MridulNegi2005/Capstone/Braillix_Hardware_Report.docx

BRAILLIX

Hardware Architecture Report

Internal Technical Reference for Software Team

Version 1.0 | 2026-05-08

Mechanical Design Team

# Table of Contents

# 1. Executive Summary

Braillix is a modular, mechanically-actuated refreshable Braille display. Each cell is a self-contained unit housing a stepper motor, a custom 6-track cam disc, 6 linkages, and 6 Braille dot pins. An external ESP32 Brain Pod provides computation, power, and user input via 3 navigation buttons. Multiple cells chain together over I2C via magnetic-snap pogo connectors.

Core innovation: The cam disc encodes all 64 Braille characters (6-bit binary) as physical track heights. Rotating the disc to the correct angular position mechanically raises or lowers the appropriate dots — no solenoids, no per-dot actuators. One motor per cell drives the entire 6-dot character.

# 2. System Architecture

## 2.1 Top-Level Components

- 1× ESP32 Brain Pod — master controller, power input, user interface
- N× Braille Cells — slaves, chained left-to-right via pogo connectors
- Each cell contains: 28BYJ-48 stepper + ULN2003 driver + cam disc + 6 linkages + Hall sensor + top plate + 6 dot caps

## 2.2 Communication

- Protocol: I2C (SDA + SCL)
- Power rail: 5 V distributed through pogo pin chain
- Pogo signals: 5V, GND, SDA, SCL (4 pins per face)
- Bus topology: Daisy-chain — pod right-face → cell 1 left-face → cell 1 right-face → cell 2 left-face → …
- Addressing: Each cell has a unique 7-bit I2C address assigned at boot or via hardware jumpers

# 3. Braille Cell — Mechanical Overview

## 3.1 Outer Box (Cell Enclosure)

- External dimensions: 68 × 68 × 57 mm (L × W × H), material: PETG
- Pogo interfaces: Both ±X faces have pogo slots (10 mm wide × 8 mm tall) at z = 30.5 mm
- Magnet pockets: 3× Ø3.2 mm × 2.1 mm deep on both ±X faces at y = [−12, 0, +12] mm — NeFeB snap alignment
- Braille 'F' emboss: Front wall (−Y) has Braille dots 1, 2, 4 embossed — tactile orientation marker for blind user

Internal Z-stack (bottom → top):

Z Range (mm) | Layer | Contents
0 – 4 | Floor | PETG shell floor
4 – 20 | Electronics pocket | ULN2003 driver board + wiring (16 mm tall)
20 – 22 | Mid-plate | 2 mm solid PETG — seals electronics from motor cavity
22 – 41 | Motor cavity | 28BYJ-48 body in motor collar on mid-plate
41 – 46 | Base plate | 5 mm PETG — motor ears mount here; cam pocket on top face
43 – 46 | Cam disc | 3 mm deep pocket; disc sits here, hub hangs below
46 – 54 | Linkage zone | 8 mm standoffs; 6 linkages travel here (12 mm total height)
54 – 57 | Top plate | 4 mm resin plate; braille holes + spring pockets

## 3.2 Motor — 28BYJ-48 Stepper

- Type: Unipolar 5-wire stepper with built-in planetary gearbox
- Step angle: 5.625° per electrical step
- Gear ratio: ~1:64 → effective 4096 full steps per revolution
- Voltage: 5 V DC, current ~150–250 mA per phase
- Driver: ULN2003A Darlington array (on breakout board in electronics pocket)
- Shaft: D-profile, 5 mm diameter, flat cut to 3 mm across flats
- Body offset: Motor body centre is −8 mm in X from shaft centre — shaft stays at x = 0 for cam alignment
- Mounting ears: at x = [−25.5, +9.5] mm on base plate

## 3.3 Cam Disc — Character Encoding

This is the mechanical core of Braillix. A single 3D-printed disc encodes all 64 Braille characters as concentric annular track heights.

Geometry:

Parameter | Value | Notes
Tracks | 6 | One per Braille dot
Inner radius | 8.0 mm | Track 0 inner edge
Track width | 1.6 mm | Per track
Track gap | 0.1 mm | Between adjacent tracks
Outer radius | 18.2 mm | = 8.0 + 6×1.7 mm
Base thickness | 2.0 mm | Dot DOWN height
Bump height | 0.8 mm | Additional height when dot UP
Ramp fraction | 30 % | Smooth rise/fall per slice (avoids shock)
Angular slices | 64 | One per Braille character (5.625° each)
Hub depth | 4 mm below | Inverted hub — top face completely clear for linkage feet
Hub diameter | 9 mm OD | D-shaft socket: 5.2 mm dia, flat to 3.2 mm

Encoding scheme: State index N is at angle N × 5.625°. For each track T, bit T of N determines whether track T at that angle is high (+0.8 mm bump) or low (base only). All 6 tracks are read simultaneously by 6 linkage feet sitting at Y = 0.

Homing magnet: 1× Ø3 mm NeFeB disc press-fit on disc underside at radius = 17.35 mm, angle = 90° (+Y axis). Triggers Hall sensor on base plate when disc is at character-0 home position.

## 3.4 Linkages (Laser-cut Metal Cranks)

6 laser-cut cranks in 1 mm stainless steel or aluminium sheet. These transfer vertical cam surface height into vertical dot-pin motion.

Dot | Track r (mm) | Dot position (x, y) mm | Arm span (mm) | Assembly angle
0 | 8.85 | (−2.4, +2.6) | 11.55 | −13.0°
1 | 10.55 | (−2.4, 0.0) | 12.95 | 180.0°
2 | 12.25 | (−2.4, −2.6) | 14.88 | +10.1°
3 | 13.95 | (+2.4, +2.6) | 11.84 | −12.7°
4 | 15.65 | (+2.4, 0.0) | 13.25 | 0.0°
5 | 17.35 | (+2.4, −2.6) | 15.18 | +9.9°

Key features:

- Foot: 2.0 mm wide × 2.5 mm long, rounded tip — rides on cam track
- Arm: horizontal bar, staggered heights prevent inter-linkage collision
- Nub: 1.2 mm wide × 1.5 mm tall rectangular tab — protrudes up through top plate hole into braille cap socket
- Total height: 12.0 mm (foot bottom → nub top)
- Arm heights: dots 0,3 = 2.0 mm; dots 1,4 = 5.5 mm; dots 2,5 = 9.0 mm (staggered to prevent collision)
- Critical: All 6 feet read the cam at the same angular position (Y=0 axis) simultaneously — one motor move = one complete character change

## 3.5 Top Plate

- Material: RESIN / SLA/MSLA — FDM cannot hold Ø2.0 mm tolerance (pins jam)
- Dimensions: 60 × 60 × 4 mm
- Braille holes: 6× Ø2.0 mm through-holes — 0.1 mm clearance over 1.9 mm cap pin
- Spring pockets: 6× Ø3.5 mm × 3.0 mm deep on underside — retains return springs
- Springs: OD 3–3.5 mm, free length 6–8 mm, k ≤ 0.1 N/mm — returns dots to DOWN state
- Dot layout: Left col dots 0,1,2 at x = −2.4 mm; Right col dots 3,4,5 at x = +2.4 mm; Row pitch = 2.6 mm
- Mounting: 4× M2.5 button-head screws at ±15 mm from centre, counterbored on top
- Thumb ridge: 8 mm wide bump on bottom edge — tactile orientation aid for blind user

## 3.6 Braille Dot Caps

- Material: PETG (FDM) or resin
- Pin: Ø1.9 mm × 5.5 mm — slides freely through Ø2.0 mm top plate hole
- Flange: Ø3.0 mm × 1.0 mm below plate — prevents cap falling through hole
- Body: Ø3.5 mm × 1.5 mm above plate surface
- Bearing ball cup: Ø2.2 mm hemispherical recess on top — 2 mm stainless steel ball CA-glued in
- Linkage socket: 1.3 × 1.1 mm rectangular blind socket in pin bottom — receives 1.2 × 1.0 mm metal nub from linkage
- Touch surface: Grade-100 stainless steel bearing ball — cold, smooth, long-lasting

Dot states:

- DOWN (rest): Cam base = 2.0 mm → foot low → nub flush with plate top → ball ~0 mm proud
- UP (active): Cam bump = 2.8 mm → foot raised 0.8 mm → nub 0.8 mm above plate → ball 0.8 mm proud — felt by fingertip

# 4. ESP32 Brain Pod

## 4.1 Enclosure

- External dimensions: 74 × 38 × 58 mm (L × W × H)
- Material: PETG, split into Shell + Lid for assembly access
- Lid: 4 mm thick, barrel jack on top face, locating lip for shell alignment
- Internal space: 66 × 30 mm footprint, 54 mm internal height

## 4.2 Microcontroller — ESP32 NodeMCU 30-pin

- PCB size: 51 × 29 mm
- Mounting: 4× M2 self-tap boss posts at ±23 mm (X) × ±11 mm (Y), 4 mm above pod floor
- Programming: Micro-USB port on left face (−X wall), always externally accessible
- Wireless: 2.4 GHz WiFi + BLE — antenna faces +X through 1.5 mm thinned wall + 3 grille slots
- Logic: 3.3 V (check pin tolerance before connecting 5 V peripherals directly)
- Flash: 4 MB

## 4.3 Power Supply

- Input connector: 5.5/2.1 mm barrel jack, centre-positive, on pod lid
- Rail: 5 V distributed from pod → pogo chain → all cells
- Per-cell budget: 28BYJ-48 draws 150–250 mA; size PSU at 300 mA × cell count + 200 mA for ESP32

## 4.4 Navigation Buttons

Button | Symbol | X position | Function
Previous | ◁ raised triangle | −20 mm | Scroll / page backward
Select | ○ raised ring | 0 mm | Confirm / activate
Next | ▷ raised triangle | +20 mm | Scroll / page forward

- Switch: 6×6×5 mm DIP tactile switch — mounted on ESP32 PCB at matching positions
- Cap shaft: Ø4.0 mm × 4.5 mm — passes through Ø4.2 mm wall hole, 0.5 mm protrudes inside to press switch
- Height: z = 24.4 mm from pod bottom (42% of pod height — comfortable thumb reach)
- Symbols RAISED 0.8 mm — tactile identification for blind user without vision
- GPIO: Active LOW (switch pulls GPIO to GND); enable internal pull-up in firmware
- Debounce: 20–50 ms in firmware

## 4.5 Pogo Pin Interface (Pod → Cell 1)

- Location: Right face (+X) of pod
- Signals: 5V, GND, SDA, SCL
- Recess: 10 mm wide × 8 mm tall, 1 mm deep — prevents spring pins shorting if misaligned
- Centroid height: z = 30.5 mm from pod bottom — must match cell pogo_z exactly
- Alignment: 3× Ø3 mm NeFeB disc magnets at y = [−12, 0, +12] mm, alternating N/S — single correct orientation

# 5. Cell-to-Cell Chaining

## 5.1 Mechanical Connection

- Cells connect right-face (+X) of one cell to left-face (−X) of next
- Magnetic snap: 3× Ø3 mm NeFeB per face, alternating polarity — ~2 N hold force, fool-proof orientation
- No screws, no tongue-and-slot — magnets only (removes over-constraint)

## 5.2 Electrical Connection (Pogo Pins)

- Spring pins on +X face press against pad targets on −X face of next cell
- 4 signals passed: 5V, GND, SDA, SCL
- 1 mm recess on pad side prevents shorts during docking
- Last cell: TPU snap-fit end cap covers exposed right-face spring pins

## 5.3 I2C Bus Topology

- SDA + SCL shared across all cells on one continuous bus
- Pull-up resistors: 4.7 kΩ — place on ESP32 pod PCB
- Each cell needs a unique 7-bit address
- Suggested: Address jumper pads (J0, J1, J2) on cell PCB give 8 combinations (addresses 0x20–0x27)

# 6. Electronics Stack (Per Cell)

## 6.1 ULN2003 Driver Board

- Located in electronics pocket (z = 4–20 mm inside outer box)
- Drives 28BYJ-48 in half-step mode (8-step sequence) or full-step (4-step)
- 4 control lines from MCU: IN1, IN2, IN3, IN4
- Consider ATtiny85/ATmega328 as per-cell I2C slave: handles motor stepping + Hall sensor, reports to ESP32 master

## 6.2 Hall Effect Sensor (Homing)

- Mounted on base plate at y = +20 mm (+Y axis)
- Detects homing magnet on cam disc underside at radius = 17.35 mm, θ = 90°
- Type: Digital Hall switch — e.g. AH3144, SS49E — output active LOW when magnet present
- GPIO: 1 digital input per cell with internal pull-up
- Use: Rotate until LOW → that is character 0 / home

## 6.3 Wiring Summary

- ULN2003 ↔ Motor: 5-wire JST connector
- MCU → ULN2003: 4× GPIO (IN1–IN4)
- MCU → Hall sensor: 1× GPIO + VCC + GND
- Pogo wire bundle: 4 wires (5V, GND, SDA, SCL), cable-tied to post inside cell near +X wall

# 7. Software Interface Requirements

## 7.1 Motor Control

- Steps per revolution: 4096 full steps (64 electrical steps × 64:1 gear ratio)
- Steps per character: 4096 ÷ 64 characters = 64 full steps (or 128 half-steps)
- Max step rate: ~500 Hz before stall — use slow ramp-up; start at ~200 Hz
- Direction: Define CW / CCW in firmware based on physical motor orientation

## 7.2 Homing Sequence (run on power-up per cell)

1. Rotate motor CW until Hall sensor output goes LOW (character 0 position)
2. Record current step count as zero reference
3. All subsequent positions: target_steps = target_char × 64 from home

## 7.3 Character Display

1. Receive character code (0–63) over I2C from ESP32 master
2. Calculate delta = (target − current) × 64; choose shortest direction (CW or CCW)
3. Step motor to target position
4. Optionally verify with Hall sensor at character 0 periodically

## 7.4 Suggested I2C Protocol

- Write (display character): Master → [addr][char_code] → cell drives motor
- Read (status): Master reads [addr] → cell returns [current_char][status_byte]
- Broadcast: Address 0x00 → all cells update simultaneously (useful for page turns)

# 8. Braille Character Mapping

The cam disc uses standard 6-bit binary encoding, compatible with Grade 1 Braille (ISO 17049):

Bit | Dot number | Position | Cam track
Bit 0 (LSB) | Dot 1 | Top-left | Track 0 (innermost, r = 8.85 mm)
Bit 1 | Dot 2 | Middle-left | Track 1 (r = 10.55 mm)
Bit 2 | Dot 3 | Bottom-left | Track 2 (r = 12.25 mm)
Bit 3 | Dot 4 | Top-right | Track 3 (r = 13.95 mm)
Bit 4 | Dot 5 | Middle-right | Track 4 (r = 15.65 mm)
Bit 5 (MSB) | Dot 6 | Bottom-right | Track 5 (outermost, r = 17.35 mm)

- State 0 (0b000000) = all dots down = blank / space
- State 1 (0b000001) = dot 1 only = Braille letter A
- State 3 (0b000011) = dots 1+2 = Braille letter B
- Full mapping: ISO/ANSI Braille standard tables (provide to firmware team)

# 9. Key Dimensions — Quick Reference

Parameter | Value | Notes
Cell external | 68 × 68 × 57 mm | L × W × H
Pod external | 74 × 38 × 58 mm | L × W × H
Braille col spacing | 4.8 mm | Left col at x = −2.4, right at x = +2.4
Braille row spacing | 2.6 mm | Rows at y = +2.6, 0, −2.6 mm
Dot travel (UP) | 0.8 mm | Cam bump height — fingertip detectable
Cam outer radius | 18.2 mm | 6 tracks at 1.7 mm pitch each
Steps / character | 64 full steps | 4096 steps/rev ÷ 64 characters
Pogo centroid height | 30.5 mm | From bottom of cell or pod — must match
Nav button height | 24.4 mm | From pod bottom (42% of 58 mm)
Motor supply | 5 V, ~200 mA avg | Peak 250 mA per phase; budget 300 mA/cell
I2C pull-up | 4.7 kΩ | On pod PCB; do not duplicate on each cell
Hall sensor | r = 17.35 mm, θ = 90° | On base plate at y = +20 mm
Cam slice angle | 5.625° | 360° ÷ 64 characters

# 10. Bill of Materials (Hardware)

## 10.1 Per Braille Cell

Item | Specification | Qty | Notes
Stepper motor | 28BYJ-48, 5 V | 1 | Usually sold with ULN2003 board
ULN2003 driver | Darlington array breakout | 1 | Included with motor kit
NeFeB disc magnet | Ø3 mm × 2 mm | 6 | 3 per ±X face, alternating N/S
Bearing ball | 2 mm grade-100 stainless steel | 6 | CA-glued into dot cap cup
Compression spring | OD 3–3.5 mm, L 6–8 mm, k ≤ 0.1 N/mm | 6 | Dot return springs
Hall effect sensor | Digital switch (AH3144 or SS49E) | 1 | Homing detection, active LOW
Pogo pin | Spring contact, 5 V rated | 8 | 4 per ±X face
M2.5 screw | Button-head, 6 mm | 4 | Top plate mounting (counterbored)
M2 screw | Self-tapping, 6 mm | 4 | Cell PCB boss mounting
CA glue | Cyanoacrylate (super glue) | — | Bearing balls into cups

## 10.2 ESP32 Brain Pod

Item | Specification | Qty | Notes
ESP32 NodeMCU | 30-pin, 51×29 mm PCB | 1 | Main controller
Barrel jack | 5.5/2.1 mm panel-mount | 1 | 5 V power input on pod lid
Tactile switch | 6×6×5 mm DIP | 3 | Navigation buttons (Prev / Select / Next)
NeFeB disc magnet | Ø3 mm × 2 mm | 3 | Pod-to-cell snap alignment
M2 screw | Self-tapping, 6 mm | 4 | PCB boss mounting inside pod

Page | Braillix Hardware Report v1.0 | CONFIDENTIAL

Braillix — Hardware Architecture Report
