MridulNegi2005/Capstone/renders/braillix_assembly.stl

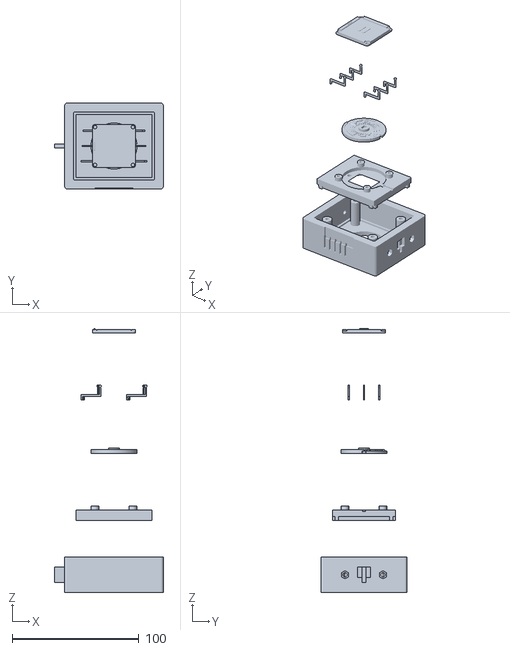
[picture p8: CAD file, 2026-05-02]
renders/braillix_assembly.stl
85.9 x 68.0 x 208.6
