MridulNegi2005/Capstone/cad/stl/linkage_asm_2.stl

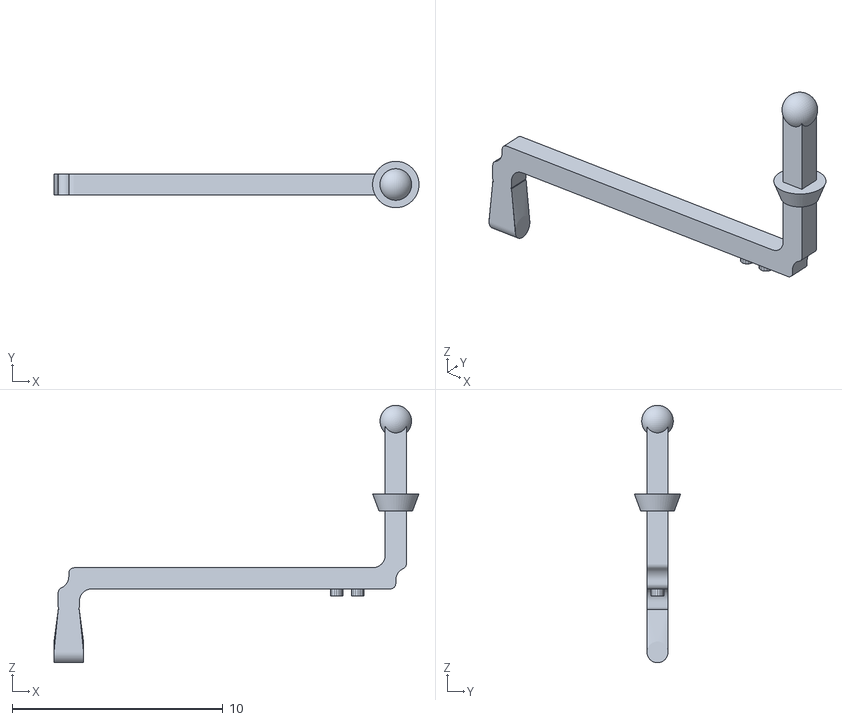
[picture p9: CAD file, 2026-07-31]
cad/stl/linkage_asm_2.stl
17.3 x 2.20 x 12.2
