MridulNegi2005/Capstone/cad/stl/linkage_asm_3.stl

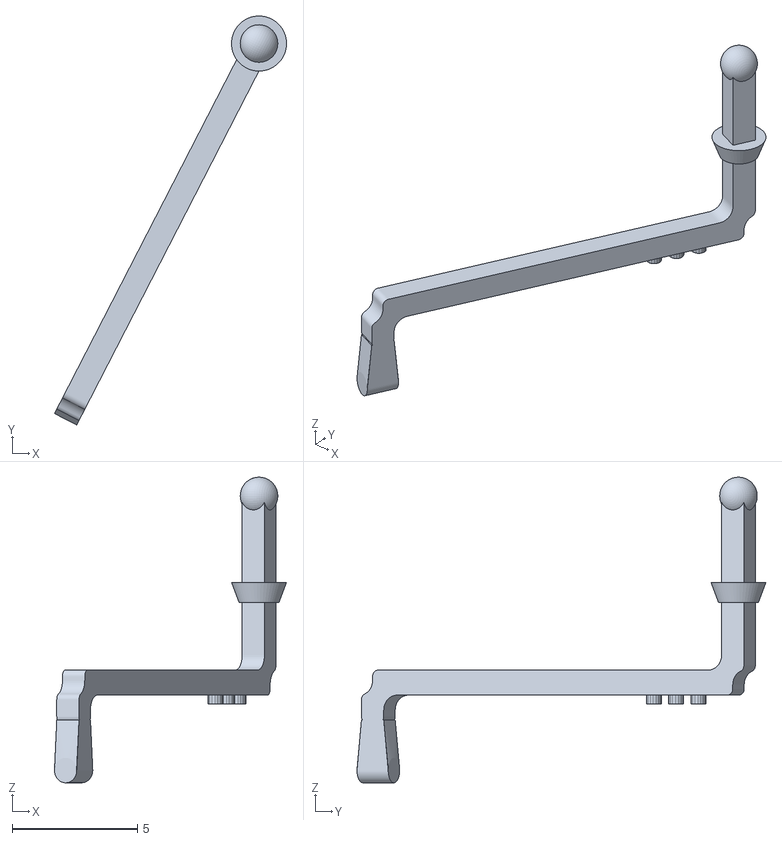
[picture p10: CAD file, 2026-07-31]
cad/stl/linkage_asm_3.stl
9.26 x 16.3 x 12.2
