MridulNegi2005/Capstone/cad/stl/linkage_asm_1.stl

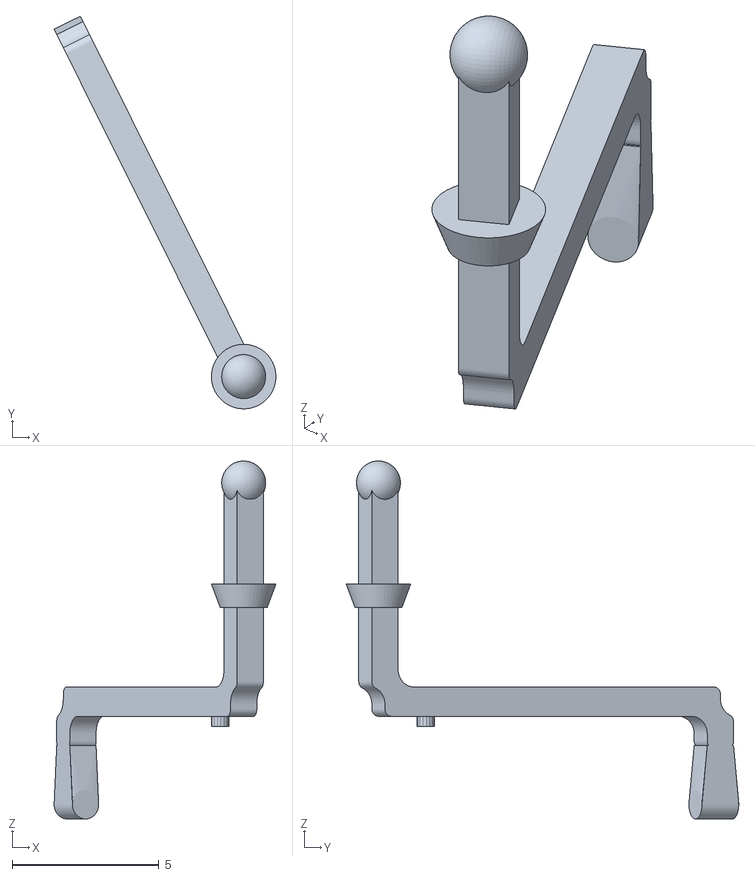
[picture p11: CAD file, 2026-07-31]
cad/stl/linkage_asm_1.stl
7.56 x 13.4 x 12.2
