MridulNegi2005/Capstone/cad/stl/linkage_asm_4.stl

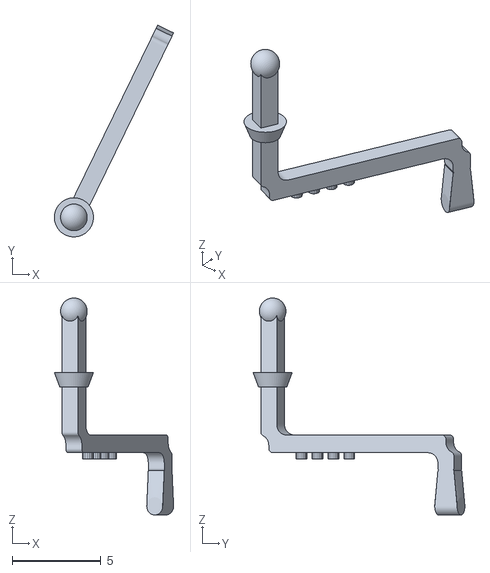
[picture p12: CAD file, 2026-07-31]
cad/stl/linkage_asm_4.stl
6.70 x 11.9 x 12.2
