MridulNegi2005/Capstone/cad/stl/linkage_asm_5.stl

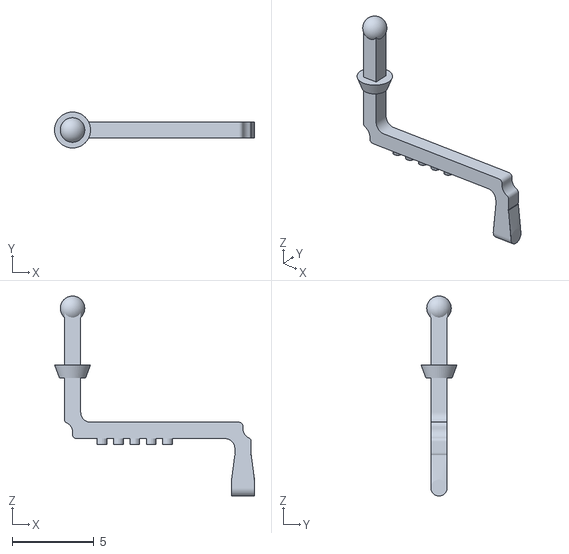
[picture p13: CAD file, 2026-07-31]
cad/stl/linkage_asm_5.stl
12.2 x 2.20 x 12.2
