MridulNegi2005/Capstone/cad/stl/linkage_asm_6.stl

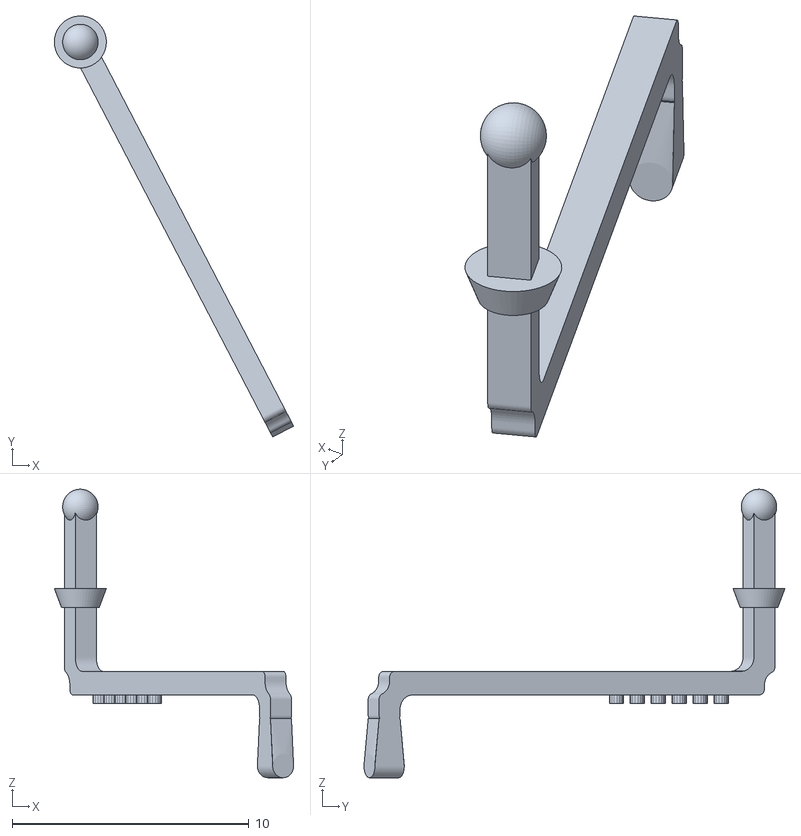
[picture p14: CAD file, 2026-07-31]
cad/stl/linkage_asm_6.stl
10.1 x 17.8 x 12.2
