MridulNegi2005/Capstone/cad/dxf/linkage_UNNAMED.dxf

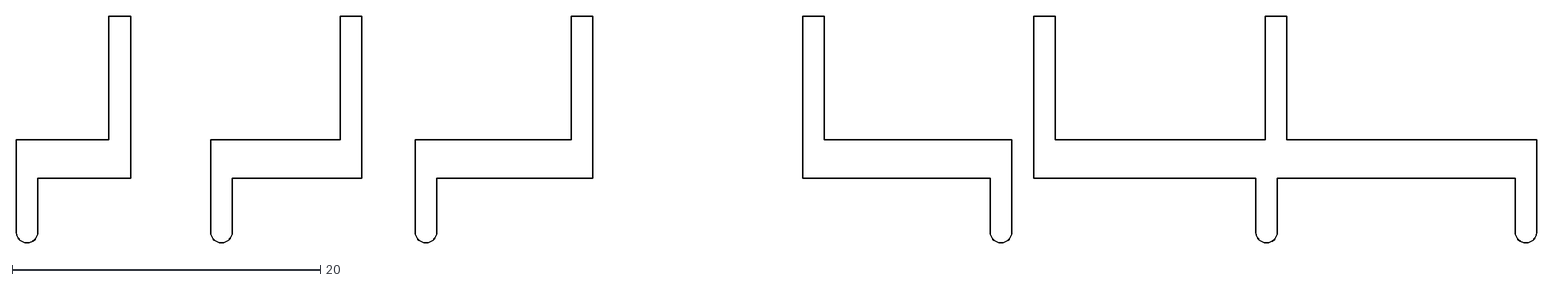
[picture p15: CAD file, 2026-05-02]
cad/dxf/linkage_UNNAMED.dxf
98.6 x 14.7
