MridulNegi2005/Capstone/cad/stl/esp32_pod_lid.stl

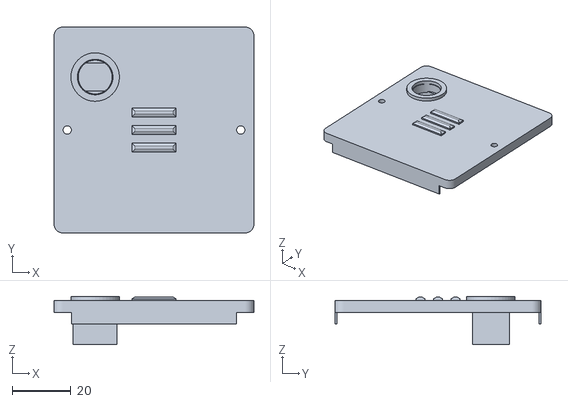
[picture p16: CAD file, 2026-08-01]
cad/stl/esp32_pod_lid.stl
68.0 x 70.0 x 16.4
