MridulNegi2005/Capstone/print_batch/Batch1_Shells/outer_box.stl

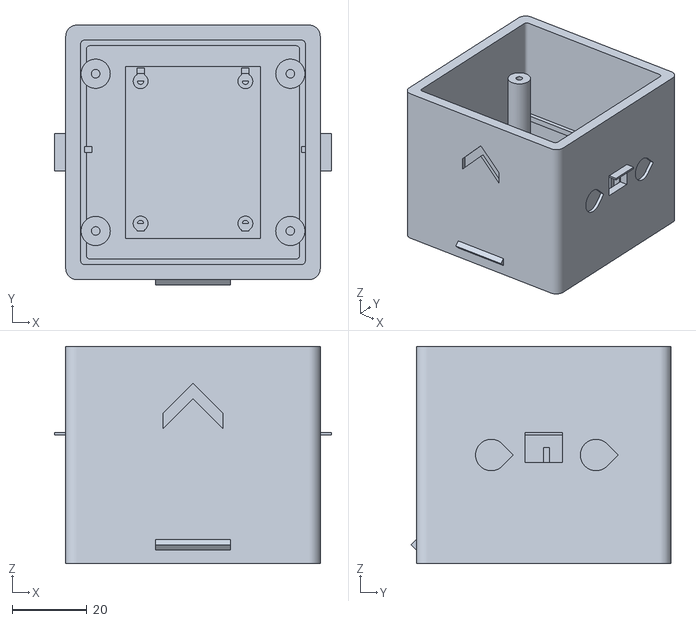
[picture p17: CAD file, 2026-07-21]
print_batch/Batch1_Shells/outer_box.stl
74.0 x 69.4 x 58.0
