MridulNegi2005/Capstone/print_batch/Batch2_Plates/esp32_pod_lid.stl

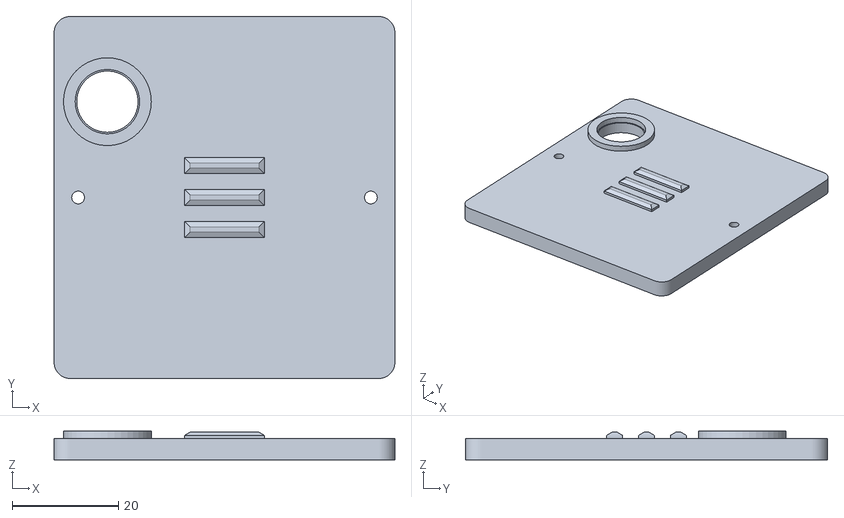
[picture p18: CAD file, 2026-07-21]
print_batch/Batch2_Plates/esp32_pod_lid.stl
64.0 x 68.0 x 5.39
