MridulNegi2005/Capstone/print_batch/Batch3_Small_Parts/pogo_end_cap.stl

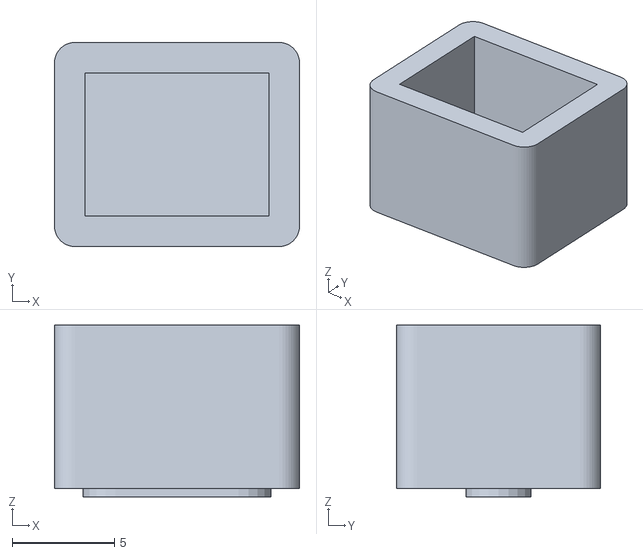
[picture p19: CAD file, 2026-07-21]
print_batch/Batch3_Small_Parts/pogo_end_cap.stl
12.0 x 10.0 x 8.40
