MridulNegi2005/Capstone/print_batch/Batch4_Resin/linkage.stl

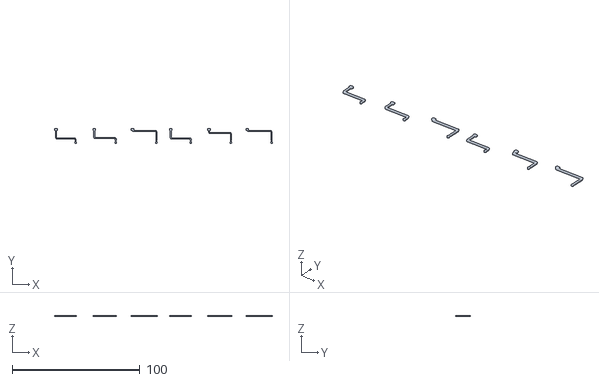
[picture p20: CAD file, 2026-07-25]
print_batch/Batch4_Resin/linkage.stl
170.9 x 12.0 x 1.00
