MridulNegi2005/Capstone/renders/Untitled.stl

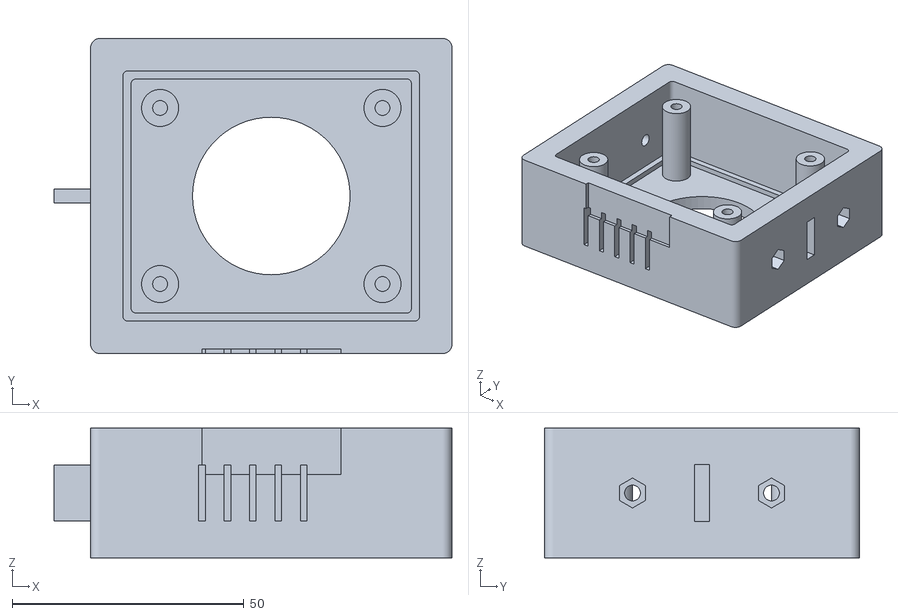
[picture p21: CAD file, 2026-05-02]
renders/Untitled.stl
85.9 x 68.0 x 28.0
