MridulNegi2005/Capstone/cad/stl/outer_box.stl

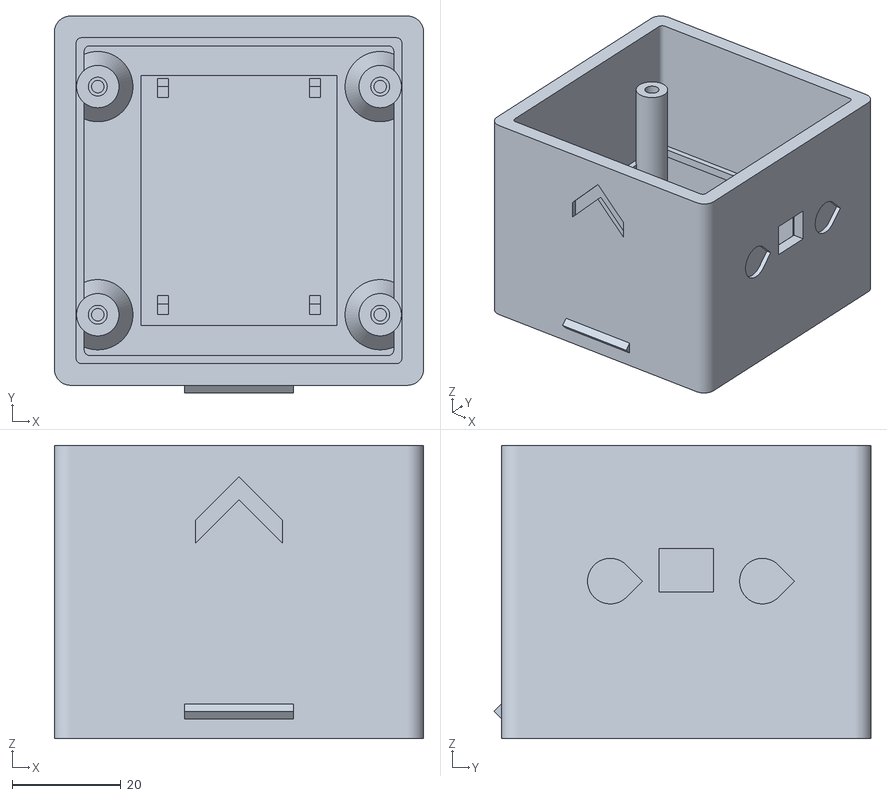
[picture p22: CAD file, 2026-08-01]
cad/stl/outer_box.stl
68.0 x 69.4 x 54.0
