MridulNegi2005/Capstone/print_batch/Batch1_Shells/esp32_pod_shell.stl

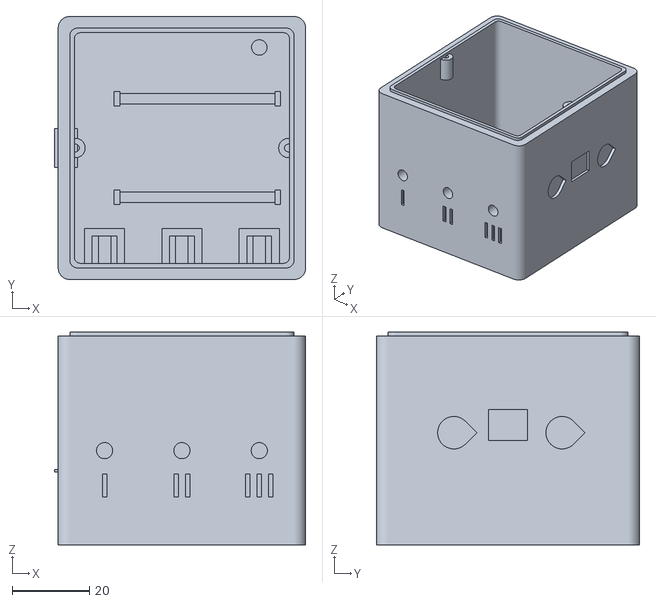
[picture p23: CAD file, 2026-07-21]
print_batch/Batch1_Shells/esp32_pod_shell.stl
65.0 x 68.0 x 55.0
