MridulNegi2005/Capstone/print_batch/Batch2_Plates/base_plate.stl

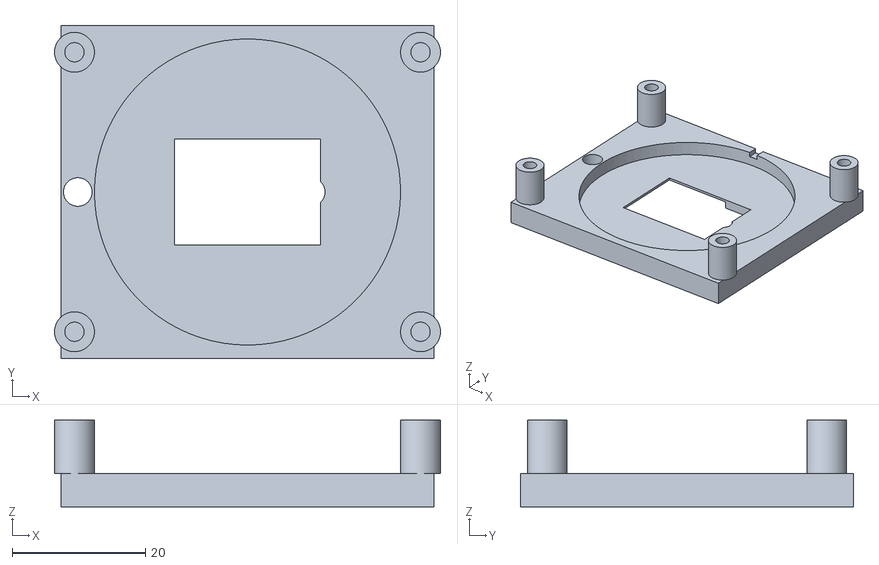
[picture p24: CAD file, 2026-07-21]
print_batch/Batch2_Plates/base_plate.stl
58.0 x 50.0 x 13.0
