MridulNegi2005/Capstone/print_batch/Batch4_Resin/braille_cam.stl

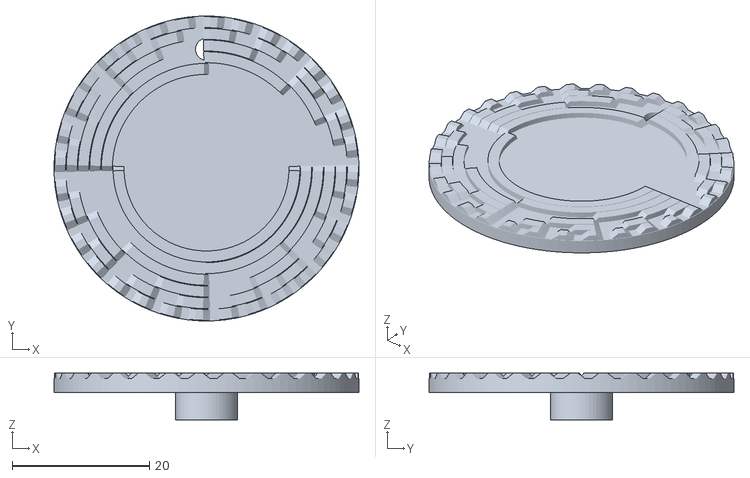
[picture p25: CAD file, 2026-07-25]
print_batch/Batch4_Resin/braille_cam.stl
44.4 x 44.4 x 6.80
