MridulNegi2005/Capstone/cad/stl/esp32_pod_shell.stl

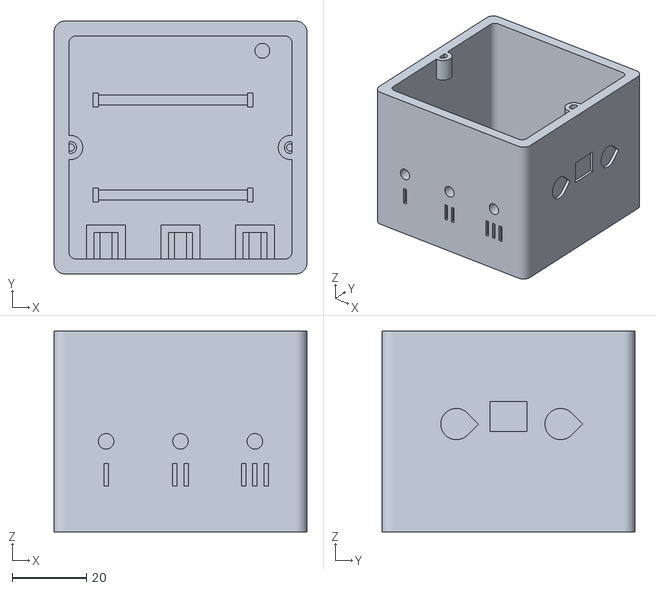
[picture p26: CAD file, 2026-08-01]
cad/stl/esp32_pod_shell.stl
68.0 x 68.0 x 54.0
