MridulNegi2005/Capstone/print_batch/Batch2_Plates/mid_plate.stl

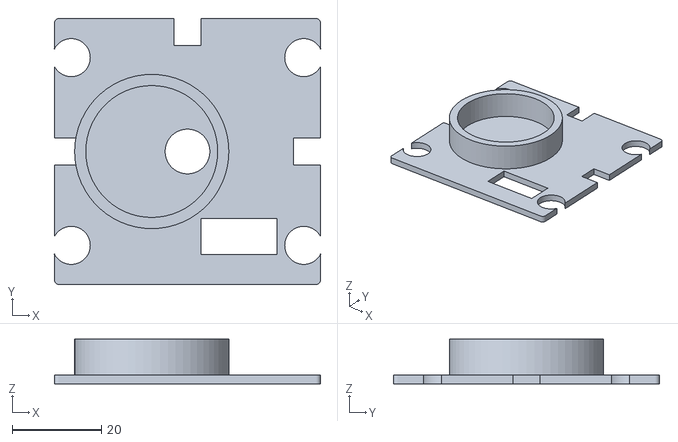
[picture p27: CAD file, 2026-07-21]
print_batch/Batch2_Plates/mid_plate.stl
59.5 x 59.5 x 10.0
