MridulNegi2005/Capstone/print_batch/Batch4_Resin/nav_cap.stl

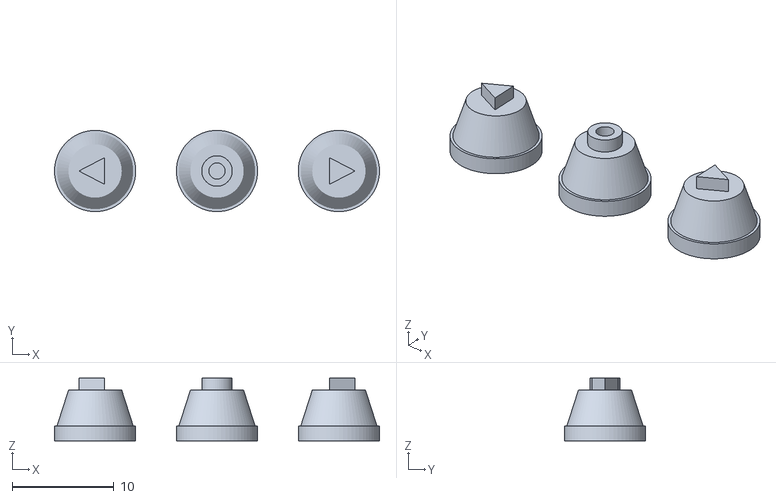
[picture p28: CAD file, 2026-06-03]
print_batch/Batch4_Resin/nav_cap.stl
32.0 x 8.00 x 6.20
