MridulNegi2005/Capstone/renders/top_plat.stl

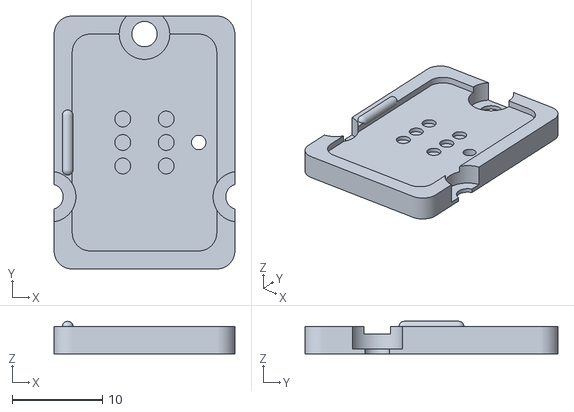
[picture p29: CAD file, 2026-02-17]
renders/top_plat.stl
20.0 x 28.0 x 3.60
