MridulNegi2005/Capstone/cad/stl/top_plate.stl

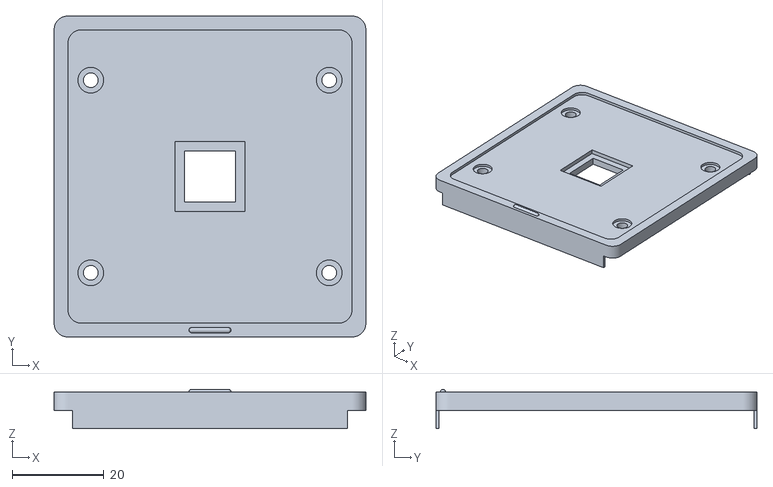
[picture p30: CAD file, 2026-08-01]
cad/stl/top_plate.stl
68.0 x 70.0 x 8.59
