MridulNegi2005/Capstone/print_batch/Batch4_Resin/top_plate.stl

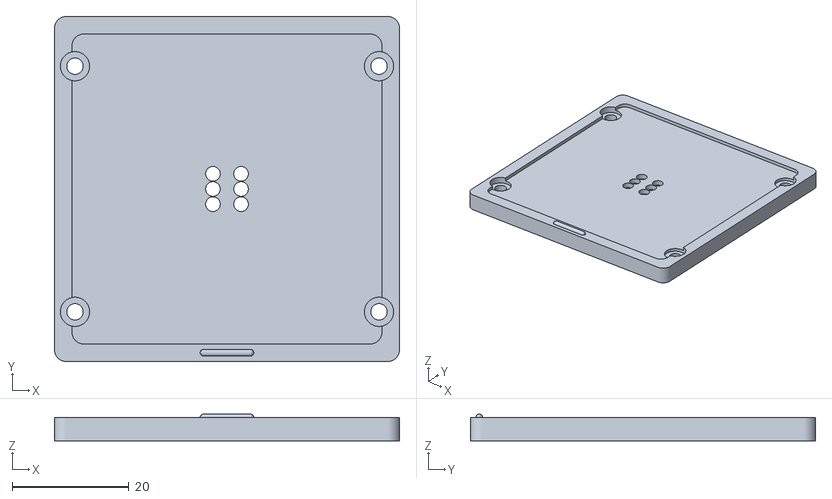
[picture p31: CAD file, 2026-06-03]
print_batch/Batch4_Resin/top_plate.stl
59.0 x 59.0 x 4.59
