MridulNegi2005/Capstone/cad/stl/print_small_parts.stl

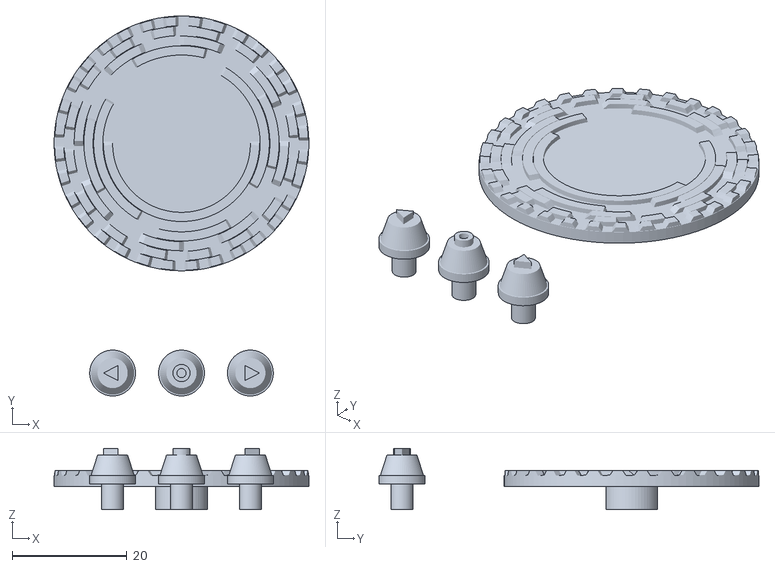
[picture p32: CAD file, 2026-07-30]
cad/stl/print_small_parts.stl
44.4 x 66.2 x 10.7
