MridulNegi2005/Capstone/cad/stl/base_plate.stl

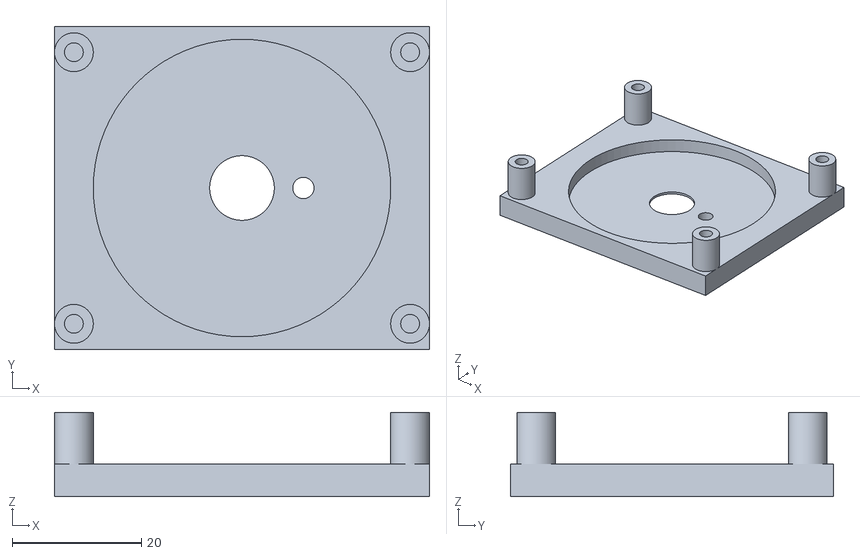
[picture p33: CAD file, 2026-07-30]
cad/stl/base_plate.stl
58.0 x 50.0 x 13.0
