MridulNegi2005/Capstone/cad/stl/nav_cap.stl

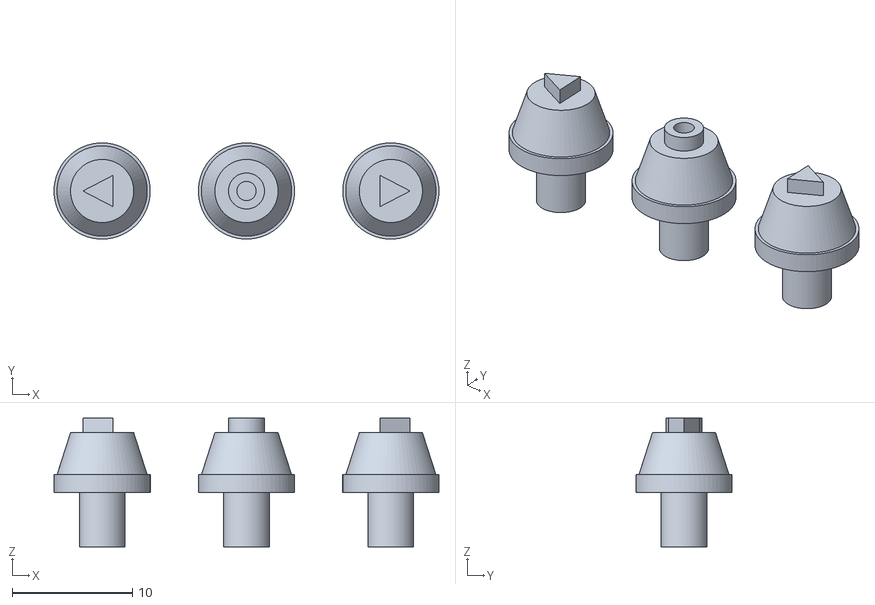
[picture p34: CAD file, 2026-07-30]
cad/stl/nav_cap.stl
32.0 x 8.00 x 10.7
