MridulNegi2005/Capstone/cad/stl/dot_insert.stl

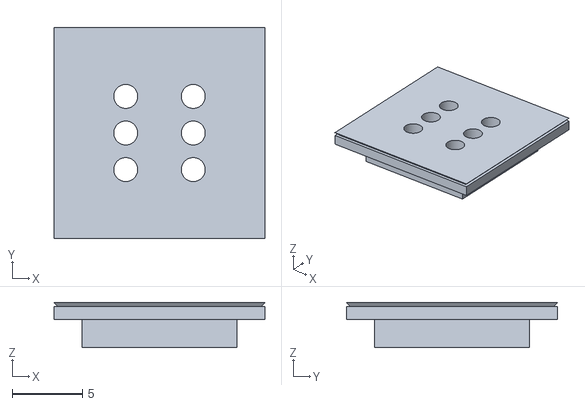
[picture p35: CAD file, 2026-07-30]
cad/stl/dot_insert.stl
15.0 x 15.0 x 3.20
