MridulNegi2005/Capstone/cad/stl/linkage.stl

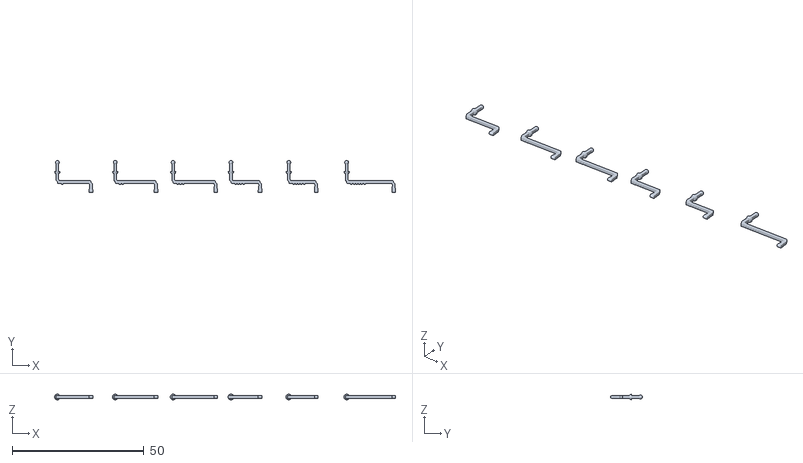
[picture p36: CAD file, 2026-07-30]
cad/stl/linkage.stl
129.7 x 12.2 x 2.20
