MridulNegi2005/Capstone/cad/stl/print_resin_cam_linkage.stl

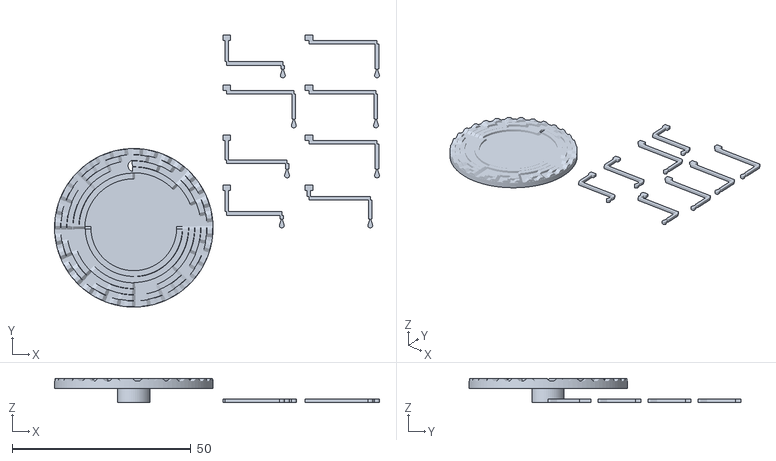
[picture p37: CAD file, 2026-07-25]
cad/stl/print_resin_cam_linkage.stl
91.0 x 76.2 x 6.80
