MridulNegi2005/Capstone/cad/stl/braille_cap.stl

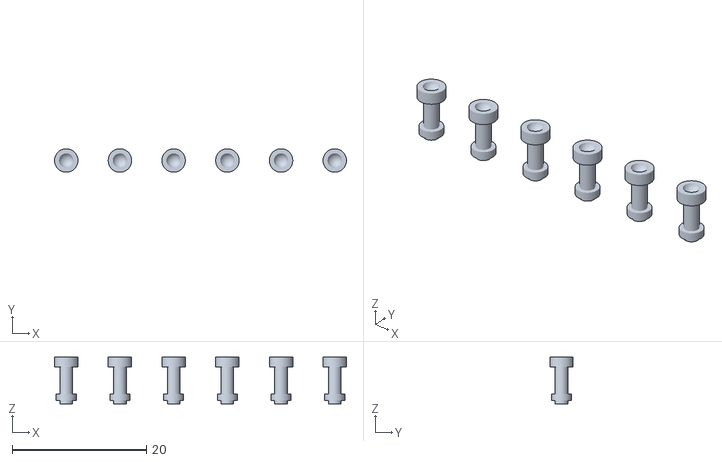
[picture p38: CAD file, 2026-05-10]
cad/stl/braille_cap.stl
43.5 x 3.50 x 7.00
