MridulNegi2005/Capstone/(list of files, cad)

Other CAD files:
cad/stl/mid_plate.stl
cad/stl/braille_cam.stl
cad/stl/pogo_end_cap.stl
_archive/test_box.scad
_archive/test_buttons_only.scad
_archive/test_buttons_only.stl
_archive/test_full_no_guards.scad
_archive/test_full_no_guards.stl
_archive/test_original.scad
_archive/test_original.stl
cad/scad/braille_cap.scad
cad/scad/dot_insert.scad
cad/scad/nav_cap.scad
cad/scad/print_resin_1_all.scad
cad/scad/print_resin_2_no_buttons.scad
cad/scad/print_resin_3_cam_linkages.scad
cad/scad/print_small_parts.scad
cad/stl/masterplan.scad
renders/braillix_assembly.blend
renders/braillix_assembly_v5.blend
