MridulNegi2005/Capstone/(commit log)

2026-05-02 refreshed designs
    [Untitled.dxf, Untitled.stl, base_plate.scad, base_plate.stl, braille_cam.scad, braille_cam2.scad, braille_cam2.stl, braillix_assembly.blend]
2026-05-02 fixed file structures
    [Untitled.stl, base_plate.scad, base_plate.stl, braille_cam.scad, braille_cam2.scad, braille_cam2.stl, braillix_assembly.stl, linkage.scad]
2026-05-02 added hardware renders
    [braillix_assembly.blend]
2026-05-05 added buttons
    [braillix_assembly.blend, outer_box.scad, outer_box.stl, test_box.scad, test_buttons_only.scad, test_buttons_only.stl, test_full_no_guards.scad, test_full_no_guards.stl]
2026-05-05 blender scene changes
    [braillix_assembly.blend]
2026-05-06 Audit redesign v4.0: fix 7 critical failures + add ESP32 pod
    - outer_box v4.0: elec_pocket 9→16mm, shell 50→57/60→68mm, mid-plate+collar,
    wire gutters, pogo recess, magnetic snap (no screws)
    - base_plate v2.2: motor body offset -8mm from shaft, widen to 56mm
    - linkage v3.0: inline feet at Y=0 (fixes Braille scrambling), dot 1/4 gap 2.0mm safe
    - top_plate v3.0: resize 52×60mm, round holes, spring pockets
    - braille_cam2 v2: hub inverts below disc, top clear
    - NEW: braille_cap (bearing ball cups), esp32_pod (74×38×58mm), linkage_comb
    (6-slit guide), pogo_end_cap (TPU cover)
    - All 9 STLs manifold ✓
    - Blender: Final + Exploded assemblies updated, shade flat, materials assigned
    - CH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
    [base_plate.scad, base_plate.stl, braille_cam2.scad, braille_cam2.stl, braille_cap.scad, braille_cap.stl, braillix_assembly.blend, esp32_pod.scad]
2026-05-06 fixed issues with joined mid plate and weird combs and few other changes
    [base_plate.stl, braille_cap.scad, braillix_assembly.blend, esp32_pod_params.scad, esp32_pod_shell.scad, linkage.scad, linkage_comb.scad, mid_plate.scad]
2026-05-06 eps32 module
    [esp32_pod.scad, esp32_pod.stl, esp32_pod_assembly.scad, esp32_pod_lid.scad, esp32_pod_lid.stl, esp32_pod_shell.stl]
2026-05-30 fix: resolve 4 showstoppers blocking first print (F1-F4, F12-F13)
    - top_plate: 60→59mm (zero clearance in 60mm cavity); 1.4mm slots→2.5mm
    round holes (2.2mm linkage nub couldn't pass 1.4mm slot)
    - linkage: centre nub on dot origin (was edge-aligned, F12)
    - braille_cam2: deepen D-bore from 2mm to 4mm through disc floor so
    28BYJ-48 shaft doesn't bottom out and lift the cam (F3)
    - base_plate: shaft clearance 7→10mm for Ø9 hub; standoff tap→Ø2.9
    clearance thru-bore enabling through-bolt fastening (F4)
    3-agent audit (Claude + Codex + Antigravity) identified these as
    print-blocking issues. All verified manifold (Simple: yes).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
    [base_plate.scad, braille_cam2.scad, braille_cap.scad, linkage.scad, top_plate.scad]
2026-05-30 feat: redesign ESP32 pod as matching brick with horizontal socket mount
    Pod is now 64×68×58mm — docking face (68×58) matches cell cross-section
    so the chain looks like a uniform row of bricks, not an alien stub.
    - ESP32 DevKit V1 mounts horizontally on two 1×15 female header strips
    in printed floor channels (plug-and-play, no soldering, CS-friendly)
    - 3× tactile switch snap-pockets in front wall (no extra PCB needed)
    - Lid screw bosses added (F14 — old lid had holes with no shell bosses)
    - Dead params removed (dock_slot, pcb_boss — conflicted with reality)
    - Pod fillet unified to 3mm (matches cell corner radius)
    - Assembly preview updated with correct horizontal DevKit ghost
    C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
    [esp32_pod_assembly.scad, esp32_pod_lid.scad, esp32_pod_params.scad, esp32_pod_shell.scad, nav_cap.scad, print_small_parts.scad]
2026-05-30 feat: add wire management, PCB mounts, and fix floating comb (F6-F11)
    outer_box v5.0:
    - boss_height 38→37 (top=z41=base plate bottom, F13)
    - boss Ø8→7.8 to avoid CGAL coplanar face at cavity boundary
    - M2.5 tap pilot (Ø2.1) for through-bolt fastening
    - 4× M2 muscle-board mounting bosses in electronics pocket (F7)
    - Pogo carrier pockets behind ±X windows (F6)
    - Floor wire gutters + L-shaped wire hooks (F6)
    - Vertical wire guides on ±X inner walls
    - Ledge ring extended 0.2mm into walls for clean CGAL merge
    mid_plate: added ±X and +Y wire pass-through notches so pogo
    and hall sensor leads can route from z31 into the pocket
    linkage_comb: body enlarged 38×38→56×46 to actually reac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
    [linkage_comb.scad, mid_plate.scad, outer_box.scad]
2026-05-30 docs: add cross-agent sync, PCB files, and pre-print audit artifact
    - .ai-sync/: cross-agent context sharing (Claude + Codex + Antigravity)
    including the full pre-print assembly audit with 14 findings
    - pcb/: braillix_muscle_board KiCad project (ATmega328P + ULN2003A,
    34×44mm, I2C slave, custom PCB replacing discrete modules)
    - CLAUDE.md, AGENTS.md: project instructions for AI agents
    - CHANGES.md: updated engineering report through v5.0
    [braillix_muscle_board.kicad_pcb, braillix_muscle_board.kicad_sch]
2026-05-30 chore: re-export all STLs after v5.0 audit fixes
    All 11 STLs re-rendered via OpenSCAD CLI — all manifold (Simple: yes).
    [base_plate.stl, braille_cam2.stl, esp32_pod_lid.stl, esp32_pod_shell.stl, linkage.stl, linkage_comb.stl, mid_plate.stl, nav_cap.stl]
2026-06-02 docs: add wiring guide, print checklist, and Blender assembly scene
    - docs/WIRING_AND_ASSEMBLY.md: complete wiring diagram for every
    connector (pogo, motor, hall, buttons, ESP32 GPIOs), assembly
    sequence for cell + pod, quick reference card
    - docs/PRINT_CHECKLIST.md: STL print table with orientations,
    settings, print order, resin-vs-PETG breakdown, hardware BOM
    - renders/braillix_assembly_v5.blend: Blender scene with all 11
    parts at v5.0 z-stack, semi-transparent shells, ghost PCBs
    - renders/build_assembly_scene.py: standalone Blender script
    [braillix_assembly_v5.blend]
2026-06-02 fix: enlarge cam disc inner_radius 8→12 to prevent linkage binding
    At inner_radius=8, track 0 arc-per-state was 0.87mm — the 2.0mm
    linkage foot straddled 2.3 states simultaneously, causing binding.
    Now at inner_radius=12, worst case is 1.6 states. Cam OD grows
    from 36.4→44.4mm; pocket enlarged 37→46mm (fits 56x50 plate).
    Also:
    - Rename braille_cam2.scad → braille_cam.scad (delete old deprecated v1)
    - Remove linkage comb from print pipeline (not needed for prototype)
    - Add print_batch/ folder with 3 batch folders for workshop
    - All STLs verified manifold (Simple: yes)
    [base_plate.scad, base_plate.stl, braille_cam.scad, braille_cam.stl, braille_cam2.scad, braille_cam2.stl, esp32_pod_lid.stl, esp32_pod_shell.stl]
2026-06-03 docs: add solderless breadboard bring-up plan + cross-agent review request
    - docs/BREADBOARD_TEST.md: wiring + test sketch for ESP32 + ULN2003 +
    28BYJ-48 + hall, fully solderless (breadboard + dupont + screw-terminal jack)
    - Flags ESP32 5V-tolerance risk: hall needs 10k+20k divider if it's a 5V module
    - Handoff to Codex + Antigravity to ID hall module + resistors from photos
    and audit wiring before power-on (.ai-sync artifact + handoff updated)
    - Also: shopping list PDF, updated workshop README with Numakers PETG-HS specs
2026-06-03 feat: add complete breadboard wiring guide + test firmware
    - docs/BREADBOARD_STEP_BY_STEP.md: every single wire numbered (12 total),
    pin-by-pin for a CS student with no hardware experience
    - firmware/breadboard_test/breadboard_test.ino: upload-and-run test sketch
    (motor CW/CCW + hall analog reading + continuous monitor)
    - Hall module ID'd as KY-024 (MH-Sensor-Series): power from 3V3, AO→GPIO34,
    no voltage divider needed. Resistors are 4.7k (I2C pull-ups for later).
    - Barrel jack is pigtail type: red=+5V, black=GND, strip ends into breadboard
2026-06-03 firmware: AccelStepper + WiFi web monitor + OTA for breadboard test
    - Replace manual half-step with AccelStepper (HALF4WIRE, IN1/IN3/IN2/IN4)
    for smooth accel/decel and non-blocking motion on ESP32
    - Add WiFi web dashboard (live hall + position, motor control buttons)
    - Add ArduinoOTA so future uploads are wireless (pass "braillix")
    - Correct STEPS_PER_REV 2048 -> 4096 (28BYJ-48 half-step, 64:1 gearbox)
    - Edge-midpoint hall homing; serial mirrors web activity
    [breadboard_test.ino]
2026-06-03 cad: v6.0 pre-patent polish + cam double-D bore
    Cam:
    - braille_cam Double-D bore (two opposite flats) + deeper hub (8mm total
    engagement) for the 10mm 28BYJ-48 shaft
    v6.0 polish (full audit in .ai-sync/artifacts/cad_audit_v6_2026-06-04.md):
    - Delete scrapped linkage_comb (stale inner_radius=8; linkages constrained
    at both ends by cam foot + top-plate hole)
    - PETG sacrificial bridges over pogo windows (outer_box) + USB cutout (pod)
    - Widen outer_box floor wire gutters 4->7mm
    - Pod tactile ID marker (braille all-6) + barrel-jack guard ring on lid
    - P/S/N braille labels beside pod nav buttons
    - End-of-chain tactile ridge on pogo_end_cap
    - Correct stale hall-gap comment in base_plate (real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
    [base_plate.scad, base_plate.stl, braille_cam.scad, braille_cam.stl, esp32_pod_lid.scad, esp32_pod_lid.stl, esp32_pod_shell.scad, esp32_pod_shell.stl]
2026-07-21 cad: fit-test fixes for box, base and mid plates
    - Magnet pockets resized for the real 8x1mm discs: 2 per dock face at y=+-14,
    teardrop tops (the 3.2mm round side-wall pockets fused closed on FDM)
    - Box walls shortened 58->54 to seat the over-cap top plate (total height stays 58)
    - Corner bosses reinforced with base gusset cones (they snapped on the print)
    - Base plate: underside ribs removed (caused a bridged/waffle underside and a 3mm
    stack error); hall pocket clearance +0.3
    - Mid plate: relief slot at the (+X,-Y) corner so the ULN2003 connector clears
    [base_plate.scad, base_plate.stl, mid_plate.scad, mid_plate.stl, outer_box.scad, outer_box.stl]
2026-07-21 cad: over-cap top plate, resin linkages, end-cap fixes
    - Top plate is now an over-cap covering the box top; skirt on +-Y only so the
    +-X docking faces stay flush; screw holes enlarged for print tolerance
    - Linkages switched from laser-cut metal to resin print (rev 3.1); stale
    reference table refreshed for inner_radius=12
    - pogo_end_cap: fixed floating interior + detached end marker; snap lips 0.5->1.0;
    bolder end-of-chain ridge
    [linkage.scad, pogo_end_cap.scad, pogo_end_cap.stl, top_plate.scad, top_plate.stl]
2026-07-21 cad: pod over-cap lid, switch cages, jack cradle
    - Pod lid is now an over-cap (skirt on +-Y, +-X flush)
    - Barrel jack relocated off the lid edge (was overflowing as an open notch a
    panel jack cannot mount in); full guard ring
    - Bare-socket jack support cradle added under the lid (PLACEHOLDER dims - measure
    the real jack before printing)
    - Switch retention rebuilt as cages rising from the floor (old snap nibs floated
    5mm off the wall and took no press force)
    - Lid screw bosses embedded into the wall (were floating -> printed as loose towers)
    - P/S/N braille -> count-coded grooves; 6-dot ID marker -> bold ridges; magnet
    pockets 8x1mm teardrop; antenna slots widened to 3mm
    [esp32_pod_lid.scad, esp32_pod_lid.stl, esp32_pod_params.scad, esp32_pod_shell.scad, esp32_pod_shell.stl]
2026-07-21 print: rebuild PETG batch, add resin batch, workshop notes
    - Regenerated all changed PETG batch STLs for v6.1/v6.2
    - New Batch4_Resin/ (braille_cam, top_plate, nav_cap, linkage x8)
    - Workshop README: resin batch + set Wall Loops = 5 so small bosses print solid
    - Rebuilt the workshop zip
    [base_plate.stl, braille_cam.stl, esp32_pod_lid.stl, esp32_pod_shell.stl, linkage.stl, mid_plate.stl, nav_cap.stl, outer_box.stl]
2026-07-21 docs: software-team handoff, sourcing guide, wiring + changelog
    - SOFTWARE_TEAM_README (md + pdf): architecture, text->braille->cam-position
    pipeline (reuses braille_converter.py), I2C chain auto-detect (count muscle
    cells per pod + total pods + same layout to every pod), pinout, protocol
    - SOURCING.md: springs (pen-spring fallback), 2mm balls, 3x2mm homing magnets,
    pogo (deferred), fasteners
    - WIRING_AND_ASSEMBLY: ULN2003 solder-flat procedure, comb-less linkage install,
    8x1mm glue-in magnets
    - CHANGES.md: v6.1 + v6.2 changelog
2026-07-21 sync: log v6.1/v6.2 history and refresh handoff
    - context.md: full v6.1/v6.2 + software-handoff entry (was stale since 2026-06-03)
    - handoff.md: refreshed next-steps; blockers = motor + jack measurements
    - cad audit artifact: v6.1 addendum (measured FDM limits + hardware spec fixes)
2026-07-21 chore: harden gitignore, untrack scratch/backup files
    - Fixed __pycache__ pattern (old __pycache__/* only matched the repo root,
    so firmware/__pycache__/*.pyc kept showing up as untracked)
    - Ignore .codex-remote-attachments/ (Codex's local scratch/attachment cache)
    - Ignore Blender .blend1/.blend2 auto-backups, OS junk, editor swap files
    - Untrack 3 already-committed .blend1 backups (~3MB dead weight); kept on disk
    - .ai-sync/ intentionally NOT ignored - it's the real cross-agent sync log
2026-07-25 cad: fix cam track/bit order and linkage foot overhang (v6.3)
    Two independent geometry bugs, both of which would have shipped to the resin
    printer. Verified numerically, not by eye.
    1. CAM - inner track dwell was too narrow to work at all.
    Bit t drove track t, so the innermost track (smallest arc) carried the LSB,
    which toggles every single one of the 64 states. Flat dwell there was ~0.88mm
    against a 1.0mm foot: the foot could never rest inside one state, it always
    straddled a ramp, so that dot sat half-up permanently. Reversed the mapping so
    the slowest bit drives the innermost track and the fastest drives the
    outermost; also ramp fraction 0.3 -> 0.2 for extra dwell. Wors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
    [braille_cam.scad, braille_cam.stl, linkage.scad, linkage.stl, print_resin_cam_linkage.scad, print_resin_cam_linkage.stl, print_resin_nav_buttons.scad, print_resin_nav_buttons.stl]
2026-07-25 cad: v7.0 spread linkage feet - mechanism is buildable
    The v6.x mechanism could not be assembled. Proven two independent ways:
    - All six feet sat on ONE radial line, so all six arms ran from the braille
    cluster to the same place: 14 overlapping pairs in plan view, needing six
    stacked arm heights. Six levels need ~11.5mm; only 6.5mm exists between the
    cam surface and the top plate. Three arms sat physically inside the plate.
    - The dot never emerged. The top plate was thickened 3->4mm long ago and
    linkage.scad was never updated, so the linkage was 1mm short: fully raised,
    the dot topped out 0.2mm BELOW the reading surface.
    - Return springs were impossible. Braille rows are 2.6mm apa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
    [braille_cam.scad, braille_cam.stl, linkage.scad, mech_layout.scad, print_resin_cam_linkage.scad, top_plate.scad, top_plate.stl]
2026-07-29 cad: v7.1 return spring moves onto the dot axis
    v7.0 seated the return spring on a pad halfway along the arm. Rejected, and
    rightly: physically the return force belongs around the braille dot, with the
    dot travelling up and down through the middle of the spring and a flange on the
    linkage for the spring to bear on.
    That layout only fits if the spring shrinks. Braille rows are 2.6mm apart, so a
    coaxial spring must stay under ~2.4mm OD, and with the old 2.2mm nub that was
    impossible at any wire gauge:
    nub 2.2mm -> spring ID 2.6, OD 3.1 COLLIDES (-0.5mm)
    nub 1.8mm -> spring ID 2.2, OD 2.7 COLLIDES (-0.1mm)
    nub 1.0mm -> spring ID 1.4, OD 2.0 FITS, 0.6mm spare
    So: 2mm OD micro compres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
    [braille_cam.stl, linkage.scad, mech_layout.scad, print_resin_1_all.scad, print_resin_2_no_buttons.scad, print_resin_3_cam_linkages.scad, top_plate.scad, top_plate.stl]
2026-07-29 cad: v7.2 top plate leaves the resin batch; fix dot-flush bug
    RESIN COST CUT ~4.5x. The 68x70mm top plate was 19.85 of the 23.8 cm3 resin
    bill, but almost all of it is plain flat structure an FDM printer handles fine.
    Only two features genuinely need resin: the six 1.7mm dot holes (the printed
    dome has to SLIDE through them, and a 0.4mm nozzle prints them ~1.4mm and
    furry) and the six 2.2mm spring bores, whose 0.4mm dividing walls are exactly
    one nozzle width on FDM.
    Those move into dot_insert.scad - a 15x15x3.2mm resin tile, 0.45 cm3 - which
    glues into a pocket in the now-PETG top plate.
    RESIN PETG
    before 19.85 cm3 (incl. plate) -
    after 4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
    [dot_insert.scad, dot_insert.stl, linkage.scad, linkage.stl, mech_layout.scad, print_resin_1_all.scad, print_resin_2_no_buttons.scad, print_resin_3_cam_linkages.scad]
2026-07-29 sync: handoff for agent switch; fix stale 8-linkage comments
    Rewrote .ai-sync/handoff.md for Codex/Antigravity pickup: current state, the two
    items deferred on Mridul's caliper measurements, next steps, and a 'do NOT
    regress' list covering the spread feet, the single common arm height, the
    link_total_h measured to the recessed reading surface, the coaxial dot spring,
    the printed dome, and the DOT_TO_BIT lookup.
    Also corrected comments in the three print_resin_* files that still described the
    old 8-linkage layout ('2 columns x 4 rows' -> 3, '+2 spares' -> two full sets,
    '~4% more' -> ~2%). Stale comments drifting from live values caused several of
    the v6.x bugs in this project, so they get f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
    [print_resin_1_all.scad, print_resin_2_no_buttons.scad, print_resin_3_cam_linkages.scad]
2026-07-29 audit: pre-assembly audit + demo package; fix 3 firmware bugs
    Five-agent pre-assembly audit ahead of a presentation demo. Every agent claim was
    re-verified against source before being accepted; several were wrong or understated
    and were corrected.
    FIRMWARE FIXES (breadboard_test.ino)
    - 'CW 90 deg' actually moved 512 steps = 45 deg. At 4096 steps/rev 90 deg is 1024.
    Label, log and self-tests all claimed 90. Fixed.
    - Full-revolution log printed '2048 steps' while moving 4096. 2048 is the exact
    full-step error this project already corrected once.
    - doHoming() never serviced the web server, so the dashboard froze for the whole
    ~10s of homing - precisely when you say 'watch it find home'.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
    [breadboard_test.ino]
2026-07-30 fix: restore nav caps to resin plate; verify Codex nav-button repair
    Verified Codex's nav_cap.scad repair of the v7.3 audit defect: CORRECT. The stem now
    starts at z=-nav_shaft_len so it projects 4.5mm behind the flange (was 3.0mm), reaching
    0.5mm past the 4mm pod wall with 0.20mm/side clearance in the 4.2mm hole. The button can
    now actually touch its switch.
    But Codex's accompanying edit to print_resin_1_all.scad silently deleted all three caps.
    It lifted them by nav_shaft_len, which is defined in esp32_pod_params.scad - and that file
    uses 'use <nav_cap.scad>'. OpenSCAD's 'use' imports MODULES ONLY, never variables, so
    nav_shaft_len was undef, the translate became [14,-32,undef], and the c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
    [esp32_pod_params.scad, nav_cap.scad, nav_cap.stl, print_resin_1_all.scad, print_small_parts.scad]
2026-07-30 docs: electronics BOM - have vs buy, and the driver-chip answer
    Mridul asked what electronics are left to buy, and whether the ULN2003 module he
    already owns can replace the 'custom chip' the muscle-board design calls for.
    Answer: yes, and no chip purchase is needed at all. The black IC on the blue board
    IS a ULN2003A - the same silicon the custom board specifies, in DIP-16 rather than
    SOIC-16. The custom muscle board exists only to give each cell its own ATmega328P
    for multi-cell I2C addressing; for a single cell the ESP32 drives the ULN2003
    directly, which is exactly what breadboard_test.ino already does.
    Also documented: ZERO discrete resistors, capacitors or diodes are needed for the
    d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
2026-07-30 docs: demo vs final product - the three stages, headers explained
    Mridul pushed back that the electronics guidance was demo-only, and said he did not
    know what a 'header' is. Both fair.
    Adds docs/DEMO_VS_PRODUCT.md covering:
    - Headers from scratch: male = pins, female = sockets, his ESP32 already has male
    rows along both edges, a '1x15 female strip' is 15 sockets in a row, two of them
    in the pod floor make a slot the ESP32 plugs into so it stays removable (the RAM
    analogy). Notes he needs NONE of this for the demo - a breadboard already is a
    large female header.
    - Three stages, with the wiring drawn for each:
    Stage 1 demo - 13 Dupont wires on a breadboard, ESP32 drives ULN2003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
2026-07-30 cad: bridge the wire-exit hole - the one unbridged overhang
    Mridul pushed back on the claim that no PETG part needs supports, arguing that holes
    cut into vertical walls must have something printed above them. He was right, and an
    audit of every wall opening in outer_box.scad found exactly one gap:
    pogo slots (+/-X) 0.6mm sacrificial bridge OK
    magnet pockets (+/-X) teardrop self-supporting OK
    front chevron shallow engraving OK
    wire exit (+Y) 15mm span, NOTHING <-- unbridged
    The wire-exit hole is 15mm wide and its top edge was a fully unsupported horizontal
    span. That either sags into the opening or forces the slicer to generate interior
    su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
    [outer_box.scad, outer_box.stl]
2026-07-30 docs: slicing guide - Kobra Neo, PETG, do-it-yourself G-code
    Mridul's first print came back damaged: screw columns snapped, supports welded in and
    unremovable, stringing between travel moves. He wants to slice on his own PC instead of
    relying on the lab teacher's settings. Lab confirmed: Anycubic Kobra Neo, and they accept
    his G-code.
    Diagnoses the three failures:
    - welded supports = supports were ON with PLA-tuned gap settings. These parts need NONE.
    - snapped columns = wall count, not infill. On a 7.8mm boss the walls ARE the part.
    - stringing = wet PETG plus Bowden-length retraction on a DIRECT DRIVE machine.
    Most online advice (5-6mm) is wrong for t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
2026-07-30 cad: remove sacrificial bridges; outer_box is now one solid
    Mridul questioned whether sacrificial bridges belong in an STL at all, arguing that
    supports are the slicer's job. He is right, and checking the spans proved the bridges
    were unnecessary:
    pogo slots 10mm span routine bridge
    wire exit 15mm span routine bridge
    USB cutout 10mm span routine bridge
    A well-cooled FDM printer bridges 20-30mm unaided, so the slicer spans all of these
    with no supports and no help from the CAD. The bridges were redundant, made the STL
    not represent the finished part, and carried a real failure mode: unremoved, they
    block the pogo pins and wires. A sagged hole edge is cosmetic; a blocked h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
    [esp32_pod_shell.scad, esp32_pod_shell.stl, outer_box.scad, outer_box.stl]
2026-07-30 cad: v7.5 defect repair — fix 8 blocking fit failures from the audit
    The v7.3 pre-assembly audit found eight defects and none had been fixed.
    Everything repairable without calipers is done here; the four that depend
    on physical measurements are tagged in-source with MEASURE (Mnn).
    Base plate:
    - Hall pocket did not exist on the printed part. It was cut from z=2 up at
    (0,20), and the cam pocket is also cut from z=2 up with r=23 — the pocket's
    far corner was at r=22.31, so it lay entirely inside and removed nothing.
    Rebuilt as an underside pocket at (0,17.35), directly under the magnet.
    - Deleted the spring cavity. It was v6.x legacy (springs moved to the top
    plate in v7.1) and its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
    [base_plate.scad, base_plate.stl, braille_cam.scad, braille_cam.stl, dot_insert.stl, esp32_pod_lid.scad, esp32_pod_lid.stl, esp32_pod_params.scad]
2026-07-30 docs: measurement sheet for the caliper session, plus v7.5 changelog
    MEASUREMENTS_NEEDED.md — 26 measurements in plain language, no CAD terms,
    with a copy-paste answer sheet at the end. Covers how to use calipers and
    why each number matters, since the four remaining CAD defects are all
    blocked on physical numbers rather than on design decisions.
    Three items are worth doing before the calipers even arrive:
    - count the pins on one edge of the ESP32. The CAD is built for the 38-pin
    board while every doc says 30-pin; if the docs are right, the board
    cannot plug into the pod at all.
    - check barrel jack polarity with a multimeter. No reverse-polarity
    protection exists anywhere in the circ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
2026-07-30 Printing gcodes
2026-07-30 cad: fix free-standing -X wire guide; add OrcaSlicer CLI pipeline
    vertical_wire_guides() built both ribs with a non-centred cube(), which always
    grows in +X. At x = sx*29 that buried the +X rib 1mm into its wall (correct) but
    left the -X rib spanning -29..-27 against a wall face at -30 — a 1mm gap. The
    result was a 2 x 1.5 x 27mm blade, 18:1 slenderness, attached by nothing but the
    0.1mm floor overlap over 3mm2. It would have snapped or been knocked over during
    the print.
    Notably this passed the Volumes==2 check, because that 0.1mm sliver does connect
    it. Connected is not the same as attached; the volume count is necessary but not
    sufficient. Each rib is now built from an explicit per-sid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
    [outer_box.scad, outer_box.stl]
2026-07-30 gcode: re-slice outer_box after the wire-guide fix; keep gcode tracked
    Reverts the printing/gcode/ ignore rule added in the previous commit — the G-code
    was already committed deliberately in 2b3dd0e, so tracking it is the intent.
    outer_box.gcode regenerated because vertical_wire_guides() changed. Verified
    PETG / 230C / 80C in the header; 4h 33m, 55.73cm3.
2026-07-30 cad: delete vertical_wire_guides — it never guided anything
    A "wire guide" has to capture a wire on more than one side: a channel with two
    walls, a hook with an overhang, or a tie loop. This was a single flat blade,
    2 x 1.5mm in section, standing off each ±X inner wall. A wire laid against it
    falls straight off. The name promised retention the geometry could not deliver,
    and the previous commit fixed how it was attached without asking whether it
    should exist.
    Removed rather than repaired:
    - 27mm tall at 1.5mm thick is 18:1 slenderness, the same class of slender feature
    that has already broken on real prints of this box.
    - It targeted wires from the pogo carrier, whose dimensions are al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
    [outer_box.scad, outer_box.stl]
2026-07-30 cad: document a 2mm arithmetic error in base_plate_z
    Found while verifying that the mid-plate still fits after the wire-guide removal.
    It does — 0.25mm/side in the cavity, 1.25mm of bearing on the ledge, 0.35mm/side
    around the corner bosses. But checking the height turned up a pre-existing bug.
    base_plate_z is commented as 4(floor) + 16(elec) + 2(midplate) + 19(motor) = 41.
    That never counts the 2mm ledge. The mid-plate cannot sit level with the ledge —
    its edge is at 29.75 and the ledge opening is 28.5, so it rests on top. Real
    seating is z 22..24, putting the motor face at 43.
    Not corrected here on purpose. Setting it to 43 raises the base plate to 48 and
    the standoffs carry the top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
    [outer_box.scad]
2026-07-31 docs: rewrite measurement sheet in plain + technical terms; update handoff
    Mridul could not follow the previous version — it used technical terms without
    explaining them. Every measurement is now written twice: a plain-English
    instruction with zero jargon, and the proper technical name so he recognises it
    in datasheets and shops. Added a six-word glossary (diameter, bore, pitch, boss,
    ear, flat-to-flat) and reworded the copy-paste answer sheet to match.
    Handoff rewritten to lead with the measurements as THE blocker, pointing at
    docs/MEASUREMENTS_NEEDED.pdf, and records the two lessons from this session:
    - Volumes==2 proves geometry is CONNECTED, not ATTACHED. The -X wire guide passed
    e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
2026-07-31 cad: widen USB-C access and fix PETG bed output
    [esp32_pod_params.scad, esp32_pod_shell.stl]
2026-07-31 docs: prefill component measurements from specs
    [esp32_pod_params.scad]
2026-07-31 docs: add Codex mechanical findings report; record verified R-07 finding
    Adds the web-generated findings report and records its outcome where other
    agents will actually see it, since a .docx is opaque to grep.
    Verified every figure in the report against source. Codex's arithmetic is
    correct throughout: hub interference, spring solid-height shortfall, dot proud
    error, max(dh/dtheta) = 64 mm/rad, 71-79 degree ramp slopes, and the 6mm bore
    engagement all reproduce exactly.
    Two corrections to the report:
    - F-01/F-02/F-03 are not new findings. They are the v7.3 vertical-stack defects
    already documented in-source at outer_box.scad:base_plate_z. Re-derived rather
    than discovered.
    - The repor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
2026-07-31 cad: apply owned component measurements
    [base_plate.scad, braille_cam.scad, esp32_pod_params.scad, esp32_pod_shell.stl]
2026-07-31 sim: interactive 3D mechanism simulator (Three.js, runs locally)
    Adds a real-time WebGL simulator so the cam encoding can be explained without
    working hardware. The panel demo currently depends on a mechanism that has never
    been assembled, and DEMO_SCRIPT.md already flags crossed stepper phases and campus
    WiFi as likely failures on the day.
    Blender was the wrong tool for this. It renders a fixed video and cannot provide
    orbit, X-ray or kinematics toggles, so its role changed to asset pipeline:
    renders/export_glb.py assembles the real STLs onto the z-stack, names every part,
    adds an indicative 28BYJ-48, and emits sim/3d/braillix.glb (16 objects, 45,660
    polys, 2.5MB). It fails loudly on a mis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
    [export_linkage_assembly.scad, linkage_asm_1.stl, linkage_asm_2.stl, linkage_asm_3.stl, linkage_asm_4.stl, linkage_asm_5.stl, linkage_asm_6.stl]
2026-07-31 sim: render braille dots as resin, not chrome; message for Atishay's Codex
    The dots looked wrong in the simulator. They were not a design error: verified in
    the running scene that a dome top sits at 57.198 against a reading surface of
    57.200 (flush when down) and at 58.00 when up, exactly the 0.8mm pin_lift. The
    geometry is correct.
    It was a rendering fault. The linkages carried metalness 0.92 from the original
    "shiny metallic" brief, but the dome at the top of each linkage IS the braille dot
    the reader touches, and it is printed resin. At near-1.0 metalness with no
    environment map it reflected pure black plus whatever was nearby - the red cam and
    the blue fill light - so every dot rendered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
2026-07-31 sim: fix dot/hole misalignment; restore chrome finish
    Mridul spotted that the braille domes did not sit centred in their holes. He was
    right, and it measured as exactly 0.500mm on all six dots.
    NOT a design error. Production linkage.scad is correct and its rebuilt geometry is
    vertex-identical (62,352 verts). The bug was in the simulator's assembly transform:
    linkage_3d_v4() extrudes from local z=0 to z=thickness and builds the dome at
    translate([0, total_h - dot_r, thickness/2]), so the DOT AXIS in the part's own
    frame is z=thickness/2, not z=0. Placing local z=0 on dot_pos therefore shoved every
    linkage half a thickness sideways once rotate([90,0,0]) mapped local +Z to world -Y.
    Centring t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
    [export_linkage_assembly.scad, linkage.scad, linkage_asm_1.stl, linkage_asm_2.stl, linkage_asm_3.stl, linkage_asm_4.stl, linkage_asm_5.stl, linkage_asm_6.stl]
2026-07-31 sim: remove state tinting from the dots
    Raised and lowered linkages now look identical — same chrome, no green tint, no
    emissive. The only difference is the 0.8mm of height, which is exactly what the
    real part does.
    The tint was added so the state could be read at a glance on a projector. That is
    what the braille cell readout in the corner is for; colouring the mechanism itself
    made the render describe something the hardware does not do.
    updateMechanism() is now position-only, and the per-linkage material clones went
    with it since every linkage is identical again.
2026-08-01 docs: electronics workstream — cancel the custom PCB, find a GPIO conflict
    Electronics is now a separate track from CAD. docs/ELECTRONICS_PLAN.md is its
    source of truth; mechanical issues are flagged there, never fixed there.
    CUSTOM PCB CANCELLED. The ATmega328P muscle board is TQFP-32 at 0.8mm pitch, so it
    is not hand-solderable and directly contradicts the project's build-it-ourselves
    aim. It also solves a multi-cell problem that does not exist while there is one
    cell. Everything needed for a complete working cell is already owned: ESP32,
    28BYJ-48, ULN2003 module, hall module, 5V adapter.
    Multi-cell, when it arrives, uses an MCP23017 I2C expander module - DIP,
    hand-solderable, ~Rs100,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
2026-08-01 docs: two-cell electronics design, soldering guide, and two factual corrections
    Two false facts were propagating through the docs and are now fixed everywhere:
    - A soldering iron was listed as OWNED. It is not. The claim originated in
    MASTER_BOM ("You stated basic experience and an iron") and spread. Corrected in
    ELECTRONICS_BOM.md and MASTER_BOM.md, and subtotals rebalanced.
    - Jack polarity was listed as unverified and MANDATORY-to-check in five places.
    A multimeter has since been bought and the polarity MEASURED CORRECT (red =
    positive), retiring the single largest risk to the ESP32.
    New in ELECTRONICS_PLAN.md:
    Part 9 - buying a soldering iron. The decision that matters is tempe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
2026-08-01 cad: fix the 2mm stack error; brass heat-set inserts; Monday print plan
    THE 2mm STACK ERROR IS FIXED, and with the cheapest possible change.
    The mid-plate cannot sit level with its 2mm ledge - its edge is 29.75 and the
    ledge opening is 28.5, so it rests ON TOP. The old breakdown
    "4 floor + 16 elec + 2 midplate + 19 motor = 41" silently omitted the ledge, so
    the real motor face landed at 43 and every dot with it.
    With the motor now MEASURED at 19.0mm (M2), taking 2mm out of the electronics
    pocket (16 -> 14) puts the motor face back on 41 and leaves the ENTIRE upper stack
    untouched: cam_flat_z 45, standoffs 8mm, top plate 54..58, link_total_h 12.2.
    That matters because the alternative - raisi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
    [esp32_pod_lid.stl, esp32_pod_params.scad, esp32_pod_shell.scad, esp32_pod_shell.stl, mid_plate.stl, outer_box.scad, outer_box.stl, top_plate.stl]
2026-08-01 print: adopt Codex's arc-free G-code, re-sliced on the fixed CAD
    Codex audited the existing G-code on 2026-08-02 and found a real defect in the set
    I generated: 23,372 G2/G3 arc commands in outer_box alone. The stock Anycubic
    Kobra Neo firmware is built with ARC_SUPPORT disabled, so those commands are not
    reliably executed - and OrcaSlicer renders them perfectly, so nothing looks wrong
    until the print fails. Same class of silent failure as the earlier PLA fallback.
    Its profile (enable_arc_fitting 0) and checked slice script are adopted. But its
    output was sliced at 00:49, BEFORE a53594c landed the 2mm stack fix and the brass
    insert bores, so every file has been regenerated from the current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
    [braillix_muscle_board.kicad_pcb, braillix_muscle_board.kicad_sch]
2026-08-01 docs: fix print-day troubleshooting table
    It still pointed at the deleted alt_225C folder, and the advice was backwards:
    it told you to go COOLER when stringing, but 230C is already the bottom of the
    Numakers 240 +/- 10C range. Below it you just get weak layers. Stringing is a
    moisture problem - the fix is drying the filament, and the only useful
    temperature move is upward to the alt_240C set.
2026-08-01 docs: N-cell scaling architecture and joint durability
    Multi-cell now uses one MCP23017 per brick rather than three cells sharing one. Wastes 11 of 16 I/O but makes each cell identical and self-contained: adding one is plug-in plus three address jumpers, not a rewire of its neighbours. The inter-brick cable stays a fixed four wires at any cell count, which is what the scaling claim rests on.
    State the ceiling honestly (8 per bus, 16 on the second I2C controller, 64 via a mux) and note that power, not addressing, is the first real limit at ~11 simultaneous motors.
    Fix a stale pin: Part 3 mapped IN4 to GPIO5, a strapping pin. Part 10 already used 27.
    Add Part 12 on making joints permanent.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
2026-08-01 docs: dot-flicker/clutch options; retract a false 2mm stack finding
    Two things.
    1. NEW docs/CLUTCH_OPTIONS.md — analysis of the flicker Mridul spotted: rotating
    to a new letter sweeps every intermediate state, so the dots jump repeatedly before
    settling. Measured from sim/braillix_params.json, typing "hello world" performs 359
    individual dot movements where 66 are required (5.4x waste); the worst single change
    is a->z at 59 dot movements.
    His proposed fix - drop the motor so the cam spins free - does NOT disengage
    anything, because the return springs push each linkage DOWN onto the cam and the
    linkages simply follow it down. It does still solve his stated goal: dropping ~1.2mm
    puts every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
    [outer_box.scad]
2026-08-04 sim: make Step actually turn the cam
    The rotation tween lived inside the `if (running)` branch, so Step —
    which sets running=false before picking the next letter — updated the
    corner readout while the 3D mechanism stayed frozen. Drive camDeg toward
    targetDeg unconditionally; gate only the auto-advance on running.
2026-08-04 sim: shortest-path cam rotation
    gotoIndex always unwound backwards, so 63 -> 0 cost 354 deg instead of 5.6.
    Wrap the wanted angle to the nearest equivalent of camDeg; direction falls
    out of the sign. Worst-case travel 354 -> 180 deg, and 'hello world' drops
    from 2118 to 1010 deg with the same halving of intermediate states swept.
2026-08-04 sim: numbers, capitals and braille indicator cells
    Braille is lower case by default, so what was missing was the capital sign,
    not lower-case patterns. The input handler was force-uppercasing everything,
    which hid that entirely.
    Adds digits 0-9 (a-j after a number sign), the capital / number / letter
    indicators, and eight punctuation marks. Indicators are expanded into their
    own cells because that is what the mechanism actually does - 'A1' is four
    cam indexes, not two. The cell card now names the indicator and why it is
    there, coloured blue so a sign reads differently from a character.
    Also adds docs/SIMULATOR_ROADMAP.md.
2026-08-04 sim: let the text field show real case
    text-transform:uppercase made every entry look capitalised even though the
    DOM value kept the real case, so there was no way to see what you typed now
    that case decides the capital sign.
2026-08-04 sim: capital word indicator for all-caps runs
    A doubled capital sign capitalises a whole word, so ABC is five cells
    instead of six and BRAILLIX is ten instead of sixteen. Only applied when
    the entire letter run is upper case, which is what avoids ever needing a
    capital terminator. Mixed case like McD still takes one sign per capital.
    Also records why there is no lower-case indicator: lower case is the
    default state, so a sign for it would cost a cell to announce nothing.
